autonomous-golf-cart/autonomous-golf-cart/hardware/README.md

# Cart hardware

The cart's custom mounts, enclosures, pedal mechanisms, and steering hardware, with **33 original STL exports** and a shaded CAD render of every component.

Installed cart hardware and steering-wheel assembly

Installed hardware (left) and steering-wheel assembly (right). The annotated photo shows the six-camera configuration, with three cameras facing forward and three facing rearward.

Full landscape component catalog

[Pedal actuation](#pedal-actuation) · [Steering](#steering-and-belt-drive) · [Cameras](#camera-rig) · [Sensors](#sensor-housings) · [Display and connectivity](#display-and-connectivity)

## How the parts fit on the cart

- **Steering:** the chestplate fits over the steering wheel to turn it. The steering models also include the column mount, motor/controller reference, motor pulley, and idler tensioner.
- **Pedals:** linear actuators press the gas and brake from a wooden support structure. The gripper attaches to the column stand and clamps around the steering column, preventing that structure from lifting when the actuators push down on the pedals.
- **Cameras:** camera-specific holders and PVC brackets support the camera rig. The front and back connectors hold the front and rear cameras with vibration dampers.
- **Sensors and accessories:** separate housings support the GPS and IMU; other mounts carry the operator monitor and Starlink equipment.

The installation descriptions above incorporate the builder's identification of the chestplate, gripper, column stand, and front/rear camera connectors. Other component roles follow the export names and the existing subsystem documentation.

## Files and previews

The original filenames and file contents are preserved. Each preview links to its STL; the [landscape component catalog](renders/catalog.png) shows all 33 exports at once and is embedded in both READMEs. The catalog uses Geist Regular for headings, component names, and notes, with Geist Mono Regular for labels, component numbers, and dimensions. It has a white background, warm charcoal text, muted olive details, thin neutral borders, and subtly rounded outer corners. The old front camera holder is retained as a separate revision.

These are **STL mesh exports**, rather than editable Fusion/STEP projects. STL does not encode units: the dimensions below are axis-aligned bounding boxes in the original export axes, **assuming millimeters**. Renders are individually fitted to the frame and are not shown at a common scale. Some exports contain several separate pieces, such as an enclosure and its lid.

## Pedal actuation

The brake and gas cases/covers belong to the pedal actuator assemblies. The piston arm is also shown in the supplied brake-assembly reference. The gripper and column stand retain the wooden pedal-actuator structure.

| CAD preview | Component / original file | Cart location and purpose |
|:--|:--|:--|
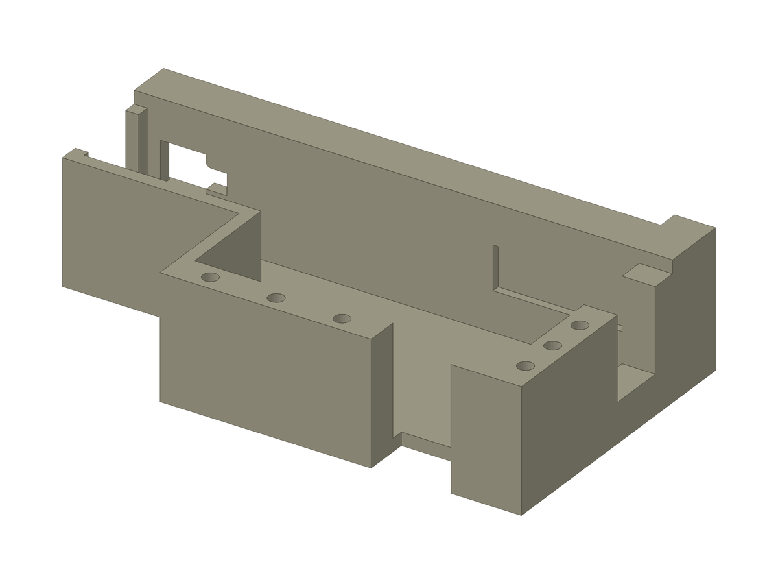
[picture p3: hardware/renders/pedal-case-brake-u.png]
Brake pedal actuator case, shaded CAD view
| [](mechanical/pedals/Pedal%20Case%20%28BRAKE%29%20U.stl) | **Brake pedal actuator case**<br>[Pedal Case (BRAKE) U.stl](mechanical/pedals/Pedal%20Case%20%28BRAKE%29%20U.stl)<br>202.5 × 112.5 × 51.5 mm | Brake pedal assembly: case for the actuator mechanism. |
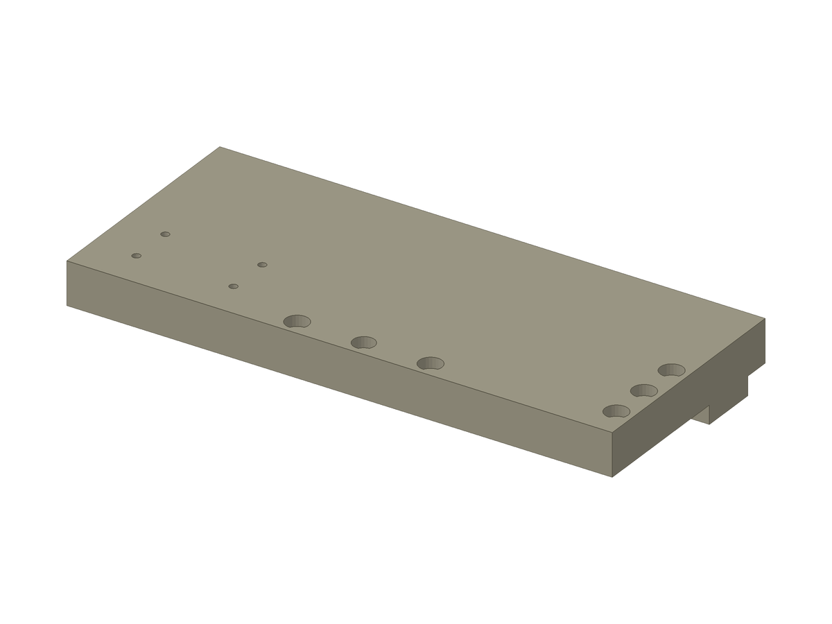
[picture p4: hardware/renders/pedal-cover-brake-u.png]
Brake pedal actuator cover, shaded CAD view
| [](mechanical/pedals/Pedal%20Cover%20%28BRAKE%29%20U.stl) | **Brake pedal actuator cover**<br>[Pedal Cover (BRAKE) U.stl](mechanical/pedals/Pedal%20Cover%20%28BRAKE%29%20U.stl)<br>202.5 × 87.5 × 23 mm | Brake pedal assembly: cover matching the brake case. |
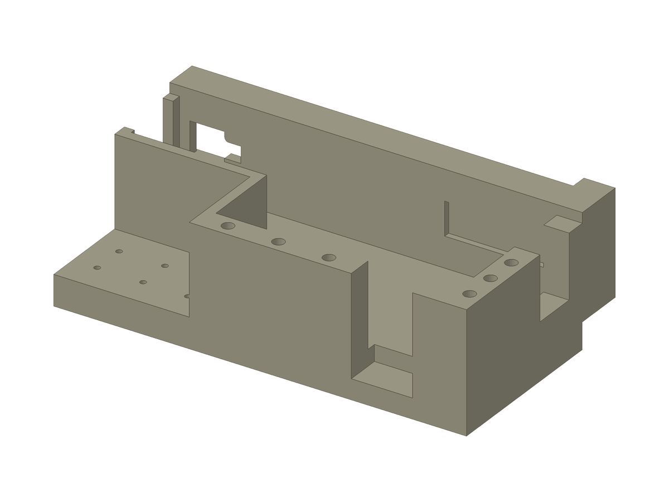
[picture p5: hardware/renders/pedal-case-gas-u.png]
Gas pedal actuator case, shaded CAD view
| [](mechanical/pedals/Pedal%20Case%20%28GAS%29%20U.stl) | **Gas pedal actuator case**<br>[Pedal Case (GAS) U.stl](mechanical/pedals/Pedal%20Case%20%28GAS%29%20U.stl)<br>202.5 × 112.5 × 64.5 mm | Accelerator pedal assembly: case for the actuator mechanism. |
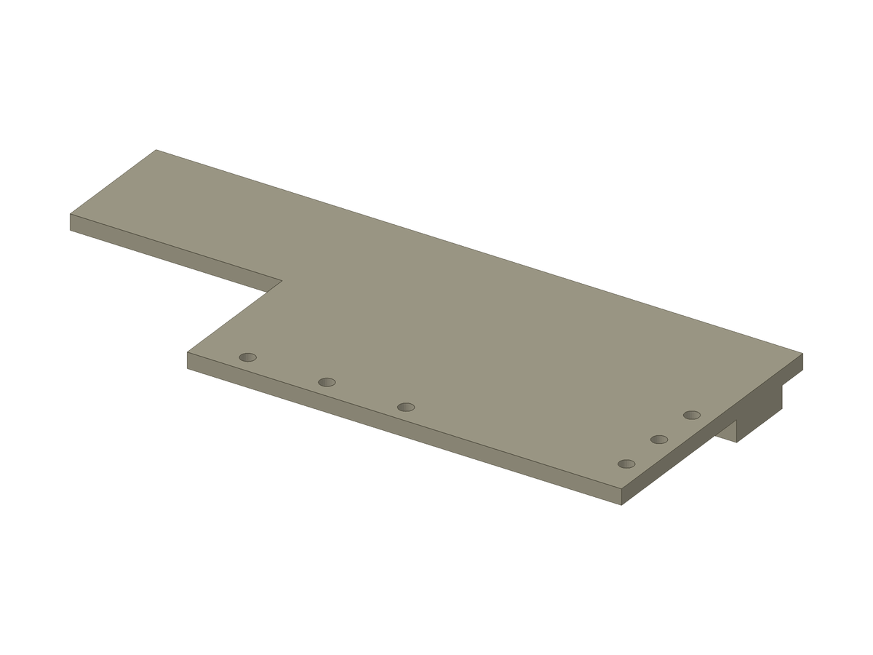
[picture p6: hardware/renders/pedal-cover-gas-u.png]
Gas pedal actuator cover, shaded CAD view
| [](mechanical/pedals/Pedal%20Cover%20%28GAS%29%20U.stl) | **Gas pedal actuator cover**<br>[Pedal Cover (GAS) U.stl](mechanical/pedals/Pedal%20Cover%20%28GAS%29%20U.stl)<br>202.5 × 87.5 × 12 mm | Accelerator pedal assembly: cover matching the gas case. |
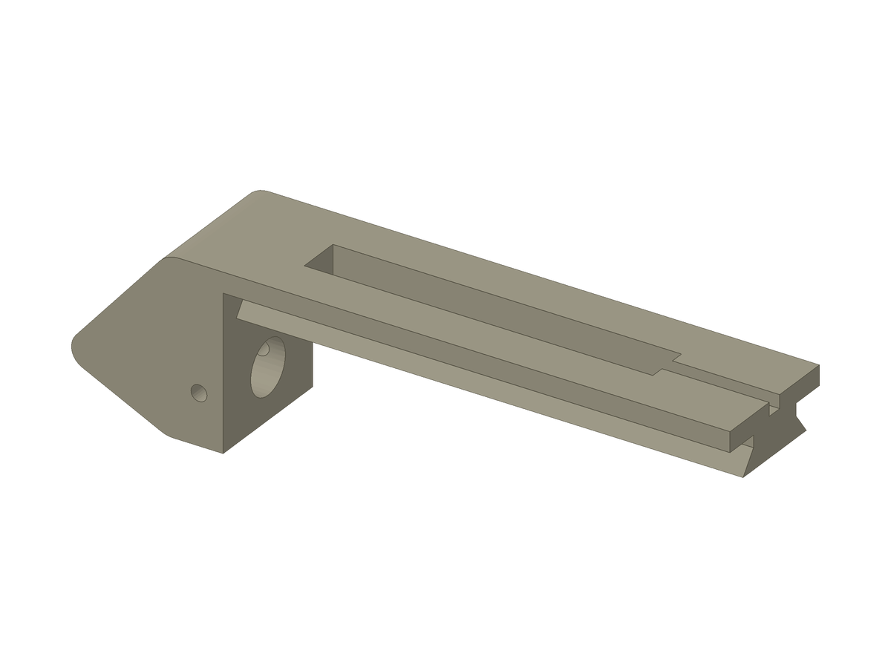
[picture p7: hardware/renders/piston-arm.png]
Piston arm, shaded CAD view
| [](mechanical/pedals/Piston%20Arm.stl) | **Piston arm**<br>[Piston Arm.stl](mechanical/pedals/Piston%20Arm.stl)<br>245.6 × 51.5 × 65 mm | Pedal actuation linkage; also visible as a component in the supplied brake-assembly reference. |
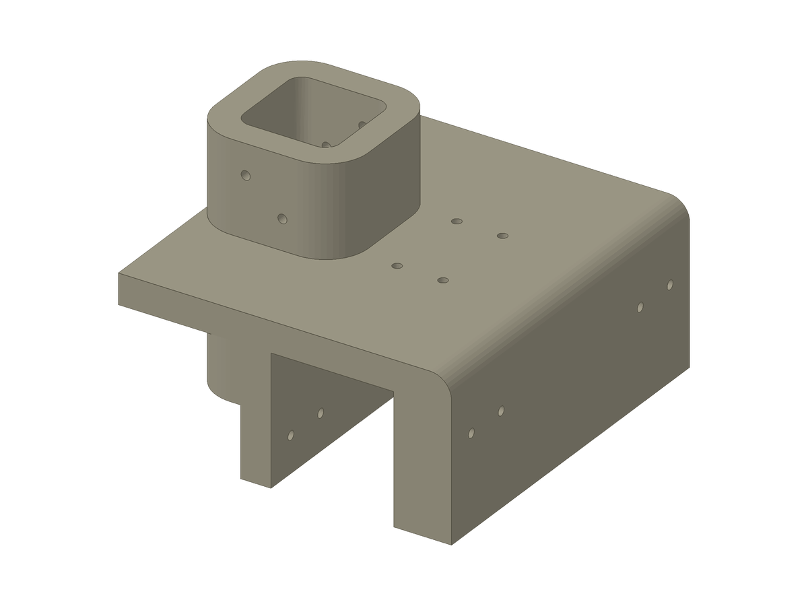
[picture p8: hardware/renders/column-stand.png]
Column stand, shaded CAD view
| [](mechanical/pedals/Column%20Stand.stl) | **Column stand**<br>[Column Stand.stl](mechanical/pedals/Column%20Stand.stl)<br>109 × 120 × 82.5 mm | Pedal-frame retention: the stand to which the gripper attaches, linking the wooden actuator-support structure to the clamp on the steering column. |
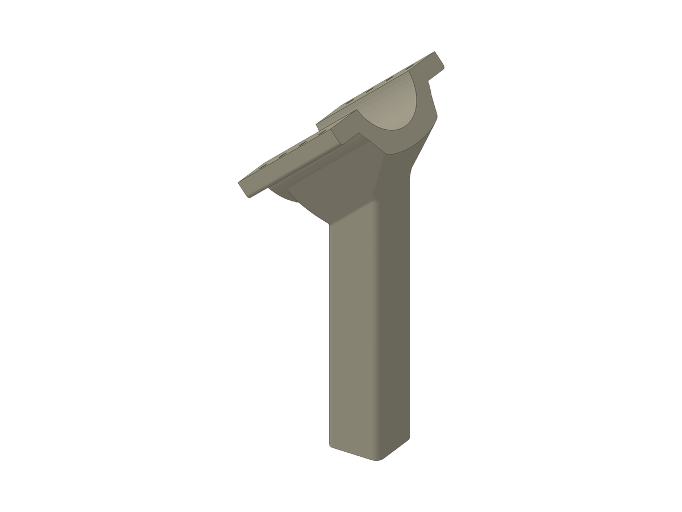
[picture p9: hardware/renders/gripper.png]
Gripper, shaded CAD view
| [](mechanical/pedals/Gripper.stl) | **Gripper**<br>[Gripper.stl](mechanical/pedals/Gripper.stl)<br>72.4 × 91.3 × 193.6 mm | Pedal-frame retention: connected to the column stand and clamped around the steering column to keep the wooden actuator frame from lifting as the actuators press the gas or brake. |
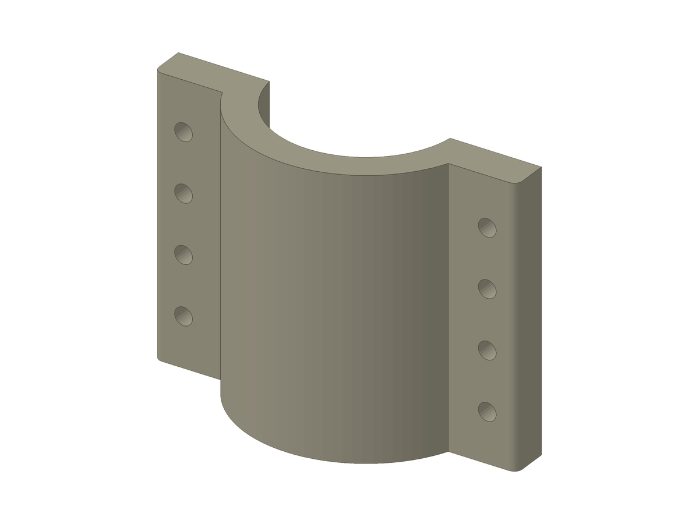
[picture p10: hardware/renders/gripper-cover.png]
Gripper cover, shaded CAD view
| [](mechanical/pedals/Gripper%20Cover.stl) | **Gripper cover**<br>[Gripper Cover.stl](mechanical/pedals/Gripper%20Cover.stl)<br>91.3 × 28.3 × 69.5 mm | Pedal-frame retention: mating cover for the gripper clamp around the steering column, securing the wooden pedal-actuator frame against lift. |

## Steering and belt drive

The chestplate is the steering-wheel interface. These parts support the ODrive-driven steering system and belt transmission. The motor export contains reference geometry for the motor and controller.

| CAD preview | Component / original file | Cart location and purpose |
|:--|:--|:--|
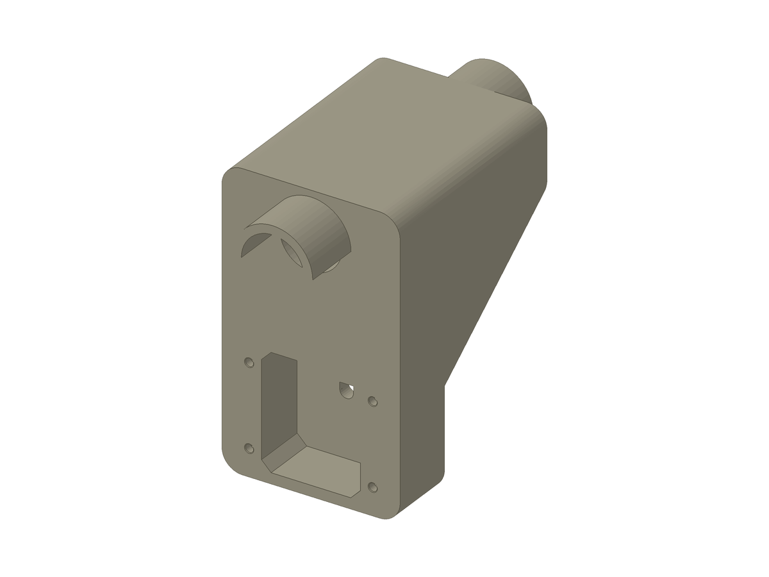
[picture p11: hardware/renders/steering-column-mount.png]
Steering column mount, shaded CAD view
| [](mechanical/steering/Steering%20Column%20Mount.stl) | **Steering column mount**<br>[Steering Column Mount.stl](mechanical/steering/Steering%20Column%20Mount.stl)<br>130 × 248 × 214 mm | Steering assembly: mounting bracket at the steering column. |
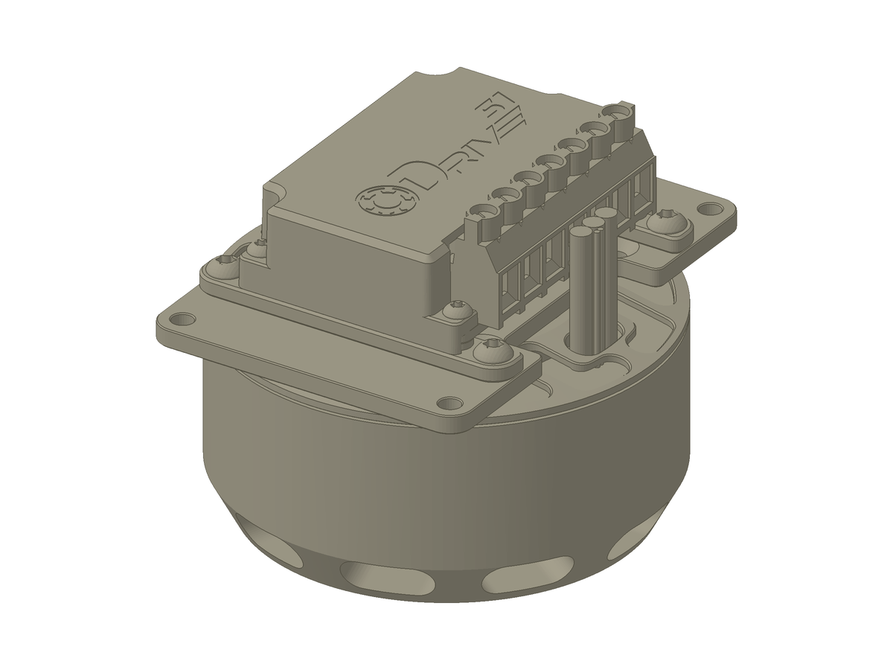
[picture p12: hardware/renders/motor.png]
Steering motor and controller model, shaded CAD view
| [](mechanical/steering/Motor.stl) | **Steering motor and controller model**<br>[Motor.stl](mechanical/steering/Motor.stl)<br>91.7 × 100 × 85.4 mm | Steering assembly: supplied motor and controller geometry for packaging and fit reference; not identified as a printable custom part. |
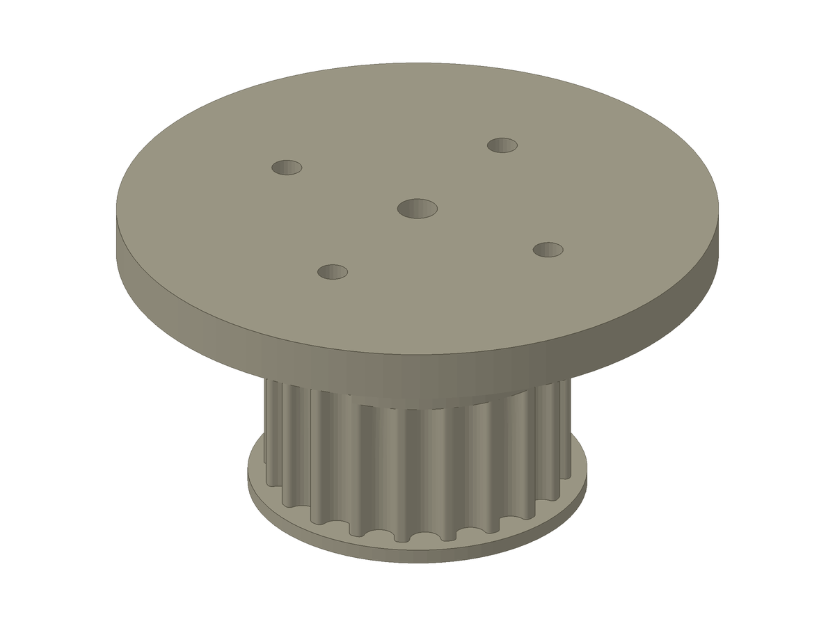
[picture p13: hardware/renders/motor-belt-pulley.png]
Motor belt pulley, shaded CAD view
| [](mechanical/steering/Motor%20Belt%20Pulley.stl) | **Motor belt pulley**<br>[Motor Belt Pulley.stl](mechanical/steering/Motor%20Belt%20Pulley.stl)<br>60 × 60 × 31 mm | Steering belt drive: pulley on the motor side. |
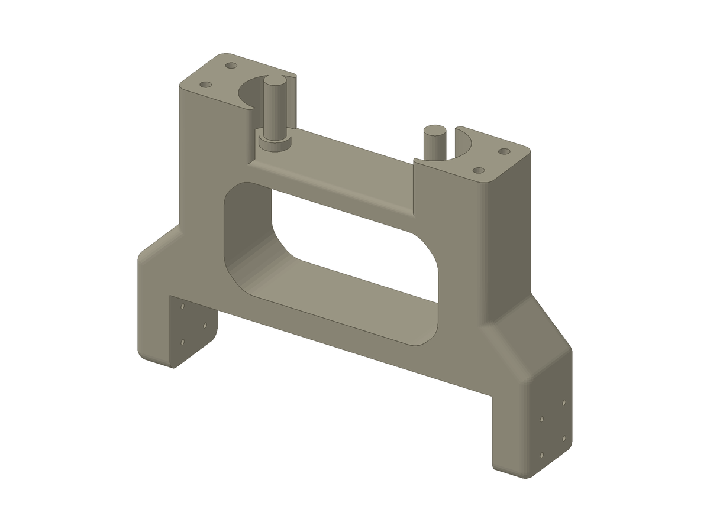
[picture p14: hardware/renders/idler-tensioner-body.png]
Idler tensioner body, shaded CAD view
| [](mechanical/steering/Idler%20Tensioner%20Body.stl) | **Idler tensioner body**<br>[Idler Tensioner Body.stl](mechanical/steering/Idler%20Tensioner%20Body.stl)<br>161 × 30 × 117 mm | Steering belt drive: body of the idler/tensioner assembly. |
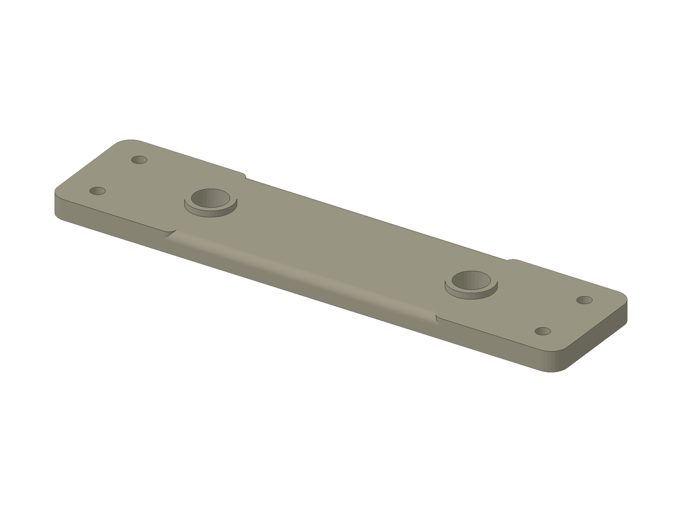
[picture p15: hardware/renders/idler-tensioner-cover.png]
Idler tensioner cover, shaded CAD view
| [](mechanical/steering/Idler%20Tensioner%20Cover.stl) | **Idler tensioner cover**<br>[Idler Tensioner Cover.stl](mechanical/steering/Idler%20Tensioner%20Cover.stl)<br>127 × 30 × 6.5 mm | Steering belt drive: cover for the idler/tensioner assembly. |
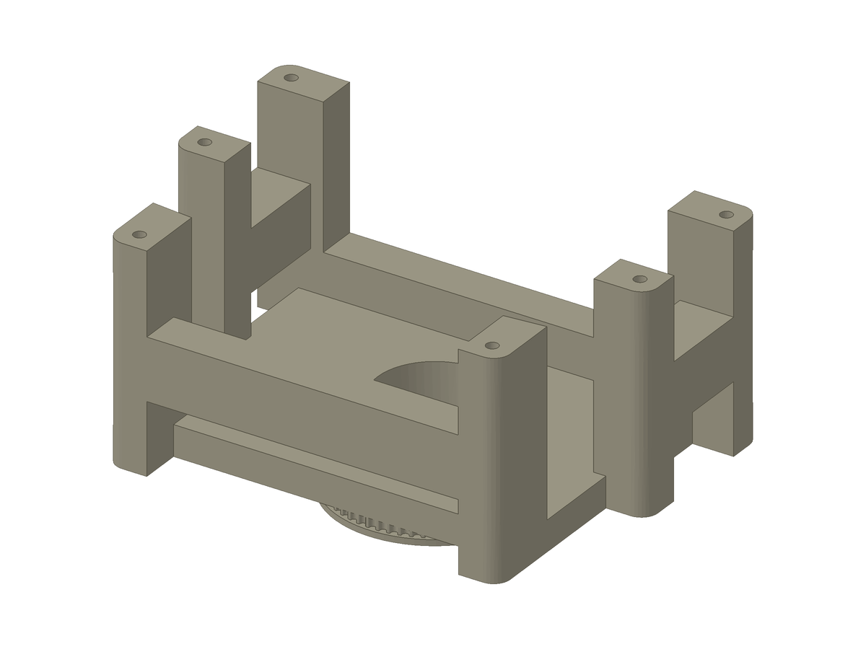
[picture p16: hardware/renders/chestplate-mount.png]
Chestplate mount, shaded CAD view
| [](mechanical/steering/Chestplate%20Mount.stl) | **Chestplate mount**<br>[Chestplate Mount.stl](mechanical/steering/Chestplate%20Mount.stl)<br>231 × 164 × 133.5 mm | Steering-wheel interface: chestplate fitted over the steering wheel to transmit the steering drive and turn the wheel. |
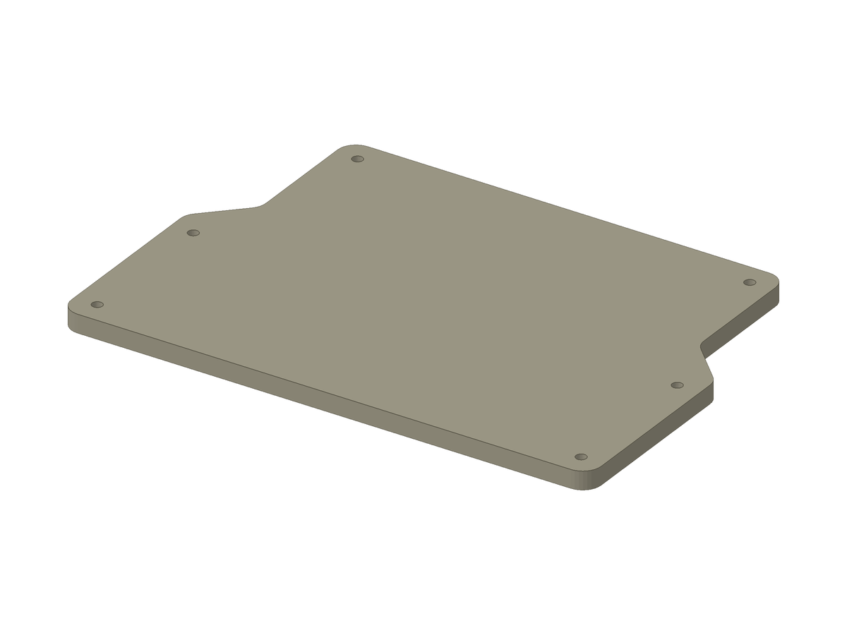
[picture p17: hardware/renders/chestplate-cover.png]
Chestplate cover, shaded CAD view
| [](mechanical/steering/Chestplate%20Cover.stl) | **Chestplate cover**<br>[Chestplate Cover.stl](mechanical/steering/Chestplate%20Cover.stl)<br>231 × 164 × 8 mm | Steering-wheel interface: cover for the chestplate assembly fitted over the steering wheel. |

## Camera rig

Front, rear, side, and PVC-mounted camera hardware, including the vibration-damped front/rear connectors. The filename marked `OLD` is an earlier front-holder revision.

| CAD preview | Component / original file | Cart location and purpose |
|:--|:--|:--|
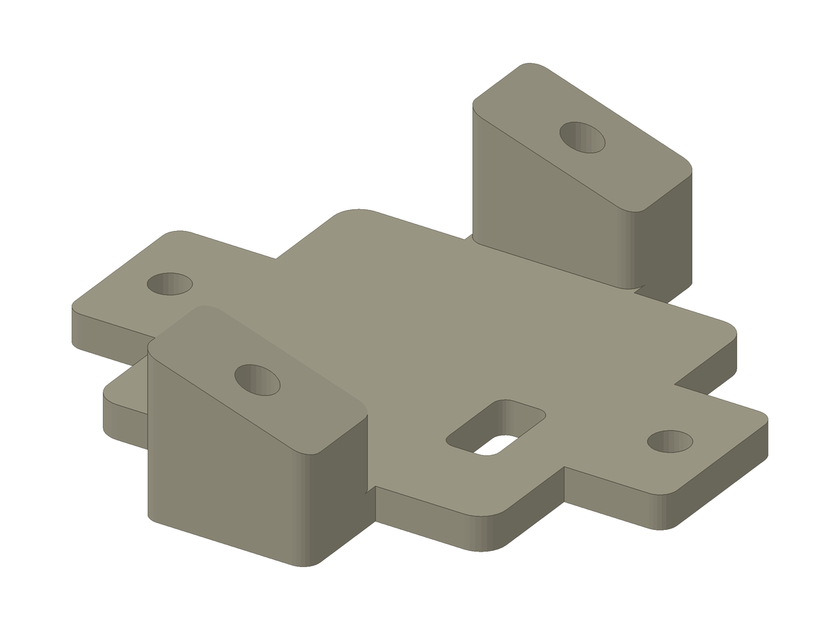
[picture p18: hardware/renders/cam-to-cart-mount.png]
Camera-to-cart mount, shaded CAD view
| [](mechanical/cameras/Cam%20to%20Cart%20Mount.stl) | **Camera-to-cart mount**<br>[Cam to Cart Mount.stl](mechanical/cameras/Cam%20to%20Cart%20Mount.stl)<br>71 × 71 × 19 mm | Camera rig: mounting interface between a camera bracket and the cart. |
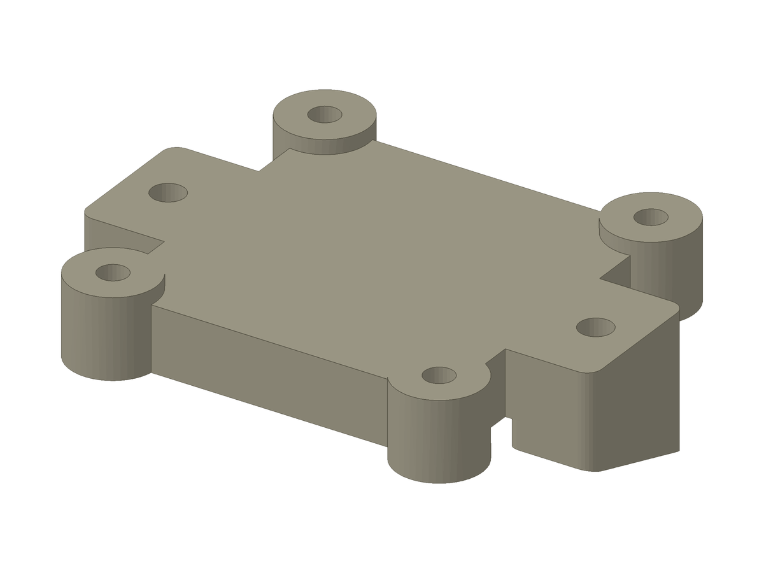
[picture p19: hardware/renders/front-cam-attachment.png]
Front camera attachment, shaded CAD view
| [](mechanical/cameras/Front%20Cam%20Attachment.stl) | **Front camera attachment**<br>[Front Cam Attachment.stl](mechanical/cameras/Front%20Cam%20Attachment.stl)<br>71 × 57 × 21 mm | Front camera rig: attachment plate/interface. |
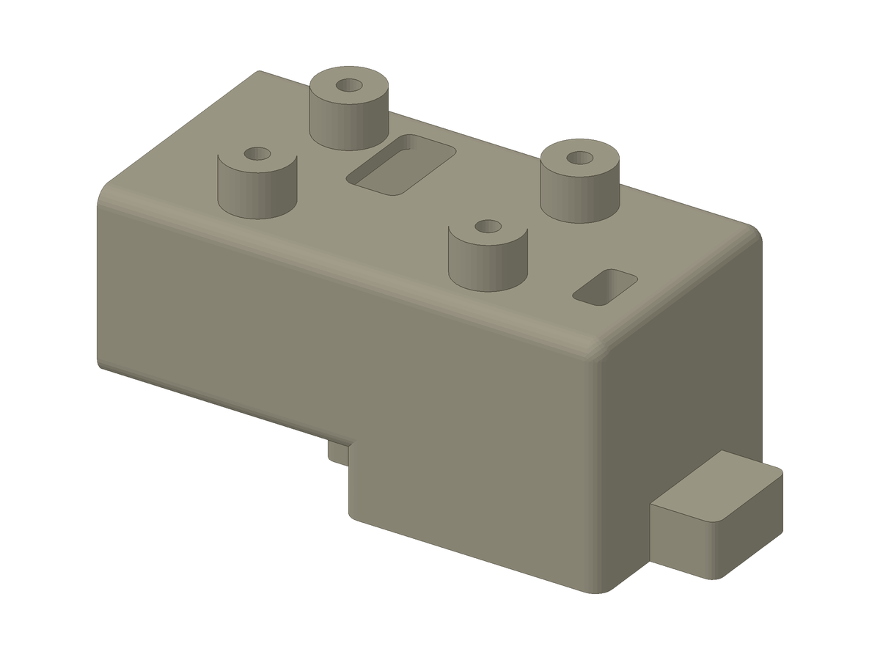
[picture p20: hardware/renders/front-cam-holder.png]
Front camera holder, shaded CAD view
| [](mechanical/cameras/Front%20Cam%20Holder.stl) | **Front camera holder**<br>[Front Cam Holder.stl](mechanical/cameras/Front%20Cam%20Holder.stl)<br>103 × 47 × 51 mm | Front camera rig: camera holder. |
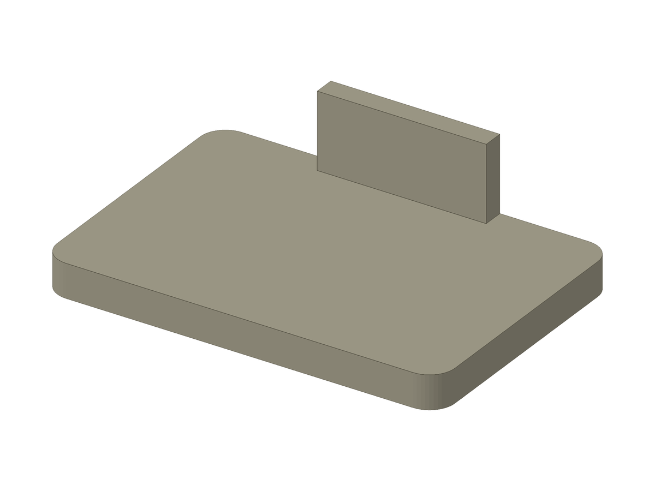
[picture p21: hardware/renders/front-cam-cap.png]
Front camera cap, shaded CAD view
| [](mechanical/cameras/Front%20Cam%20Cap.stl) | **Front camera cap**<br>[Front Cam Cap.stl](mechanical/cameras/Front%20Cam%20Cap.stl)<br>47 × 32 × 13 mm | Front camera rig: cap for the front camera holder. |
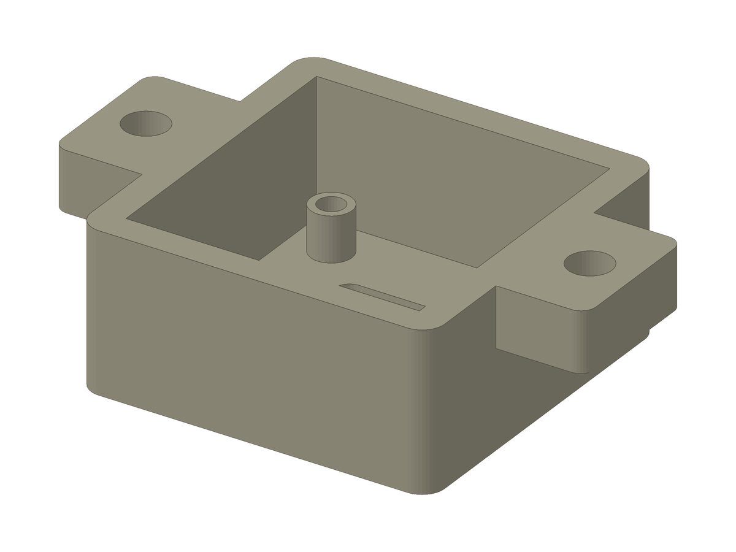
[picture p22: hardware/renders/front-wide-cam-holder.png]
Front wide-camera holder, shaded CAD view
| [](mechanical/cameras/Front%20Wide%20Cam%20Holder.stl) | **Front wide-camera holder**<br>[Front Wide Cam Holder.stl](mechanical/cameras/Front%20Wide%20Cam%20Holder.stl)<br>71 × 47 × 22 mm | Front wide-angle camera: camera holder. |
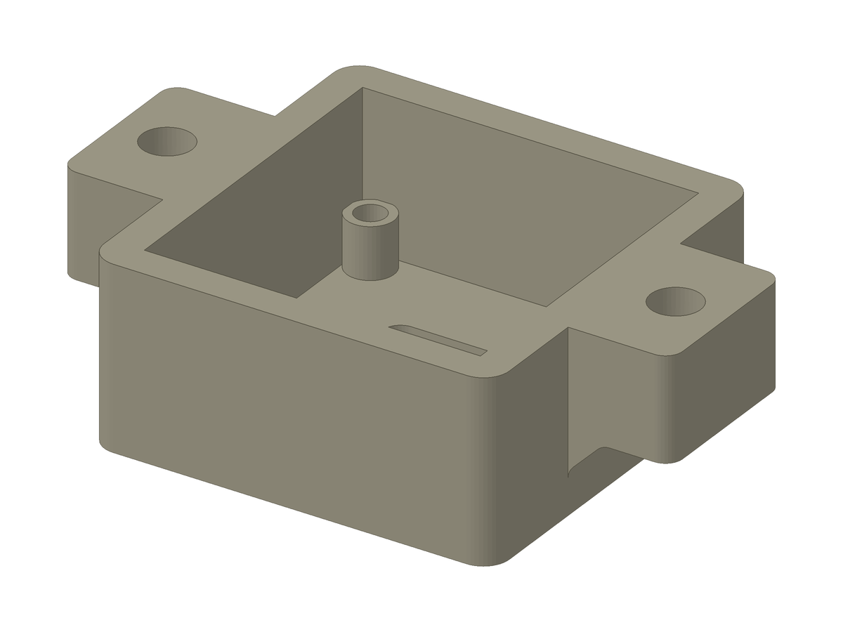
[picture p23: hardware/renders/side-cam-holder.png]
Side camera holder, shaded CAD view
| [](mechanical/cameras/Side%20Cam%20Holder.stl) | **Side camera holder**<br>[Side Cam Holder.stl](mechanical/cameras/Side%20Cam%20Holder.stl)<br>71 × 47 × 22 mm | Side-facing camera rig: camera holder. |
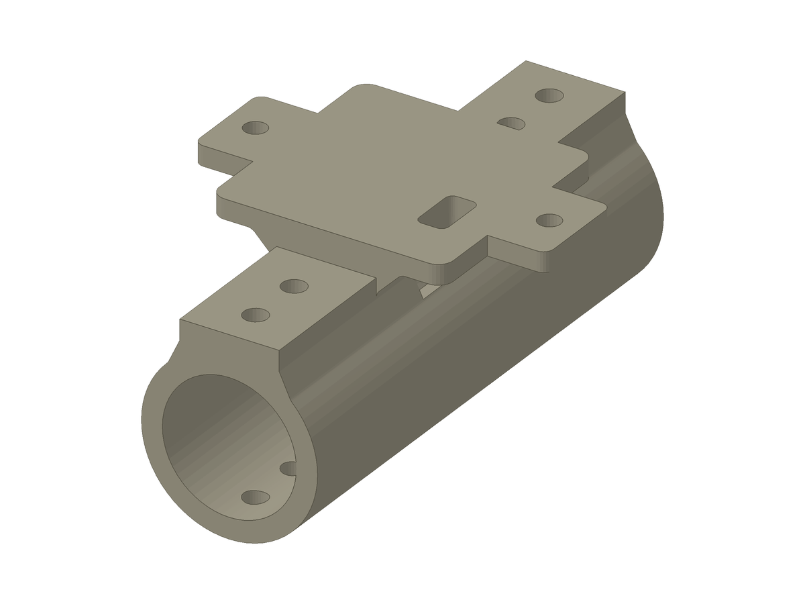
[picture p24: hardware/renders/pvc-cam-holder-norm.png]
PVC camera holder, normal, shaded CAD view
| [](mechanical/cameras/PVC%20Cam%20Holder%20Norm.stl) | **PVC camera holder, normal**<br>[PVC Cam Holder Norm.stl](mechanical/cameras/PVC%20Cam%20Holder%20Norm.stl)<br>71 × 107 × 45.4 mm | PVC camera rig: normal variant of the tube-mounted bracket. |
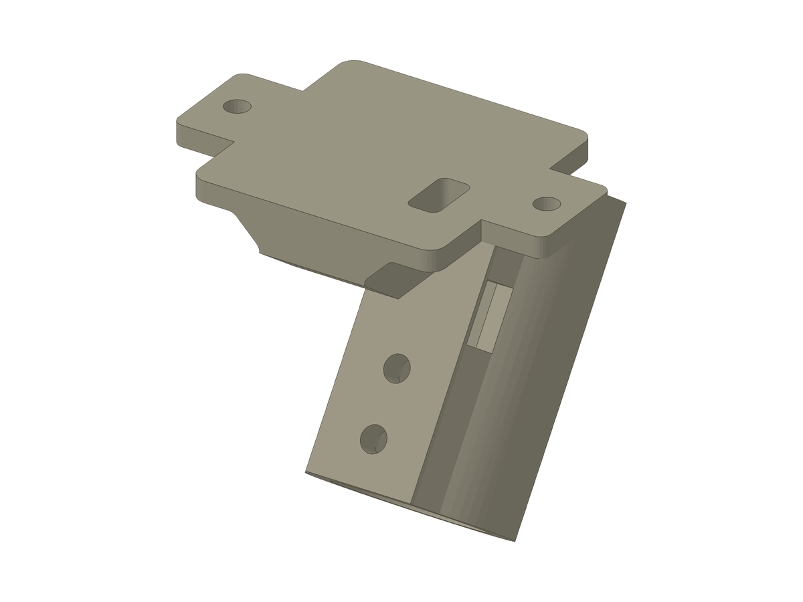
[picture p25: hardware/renders/pvc-cam-holder-left.png]
PVC camera holder, left, shaded CAD view
| [](mechanical/cameras/PVC%20Cam%20Holder%20Left.stl) | **PVC camera holder, left**<br>[PVC Cam Holder Left.stl](mechanical/cameras/PVC%20Cam%20Holder%20Left.stl)<br>71 × 76 × 77 mm | PVC camera rig: left variant of the tube-mounted bracket. |
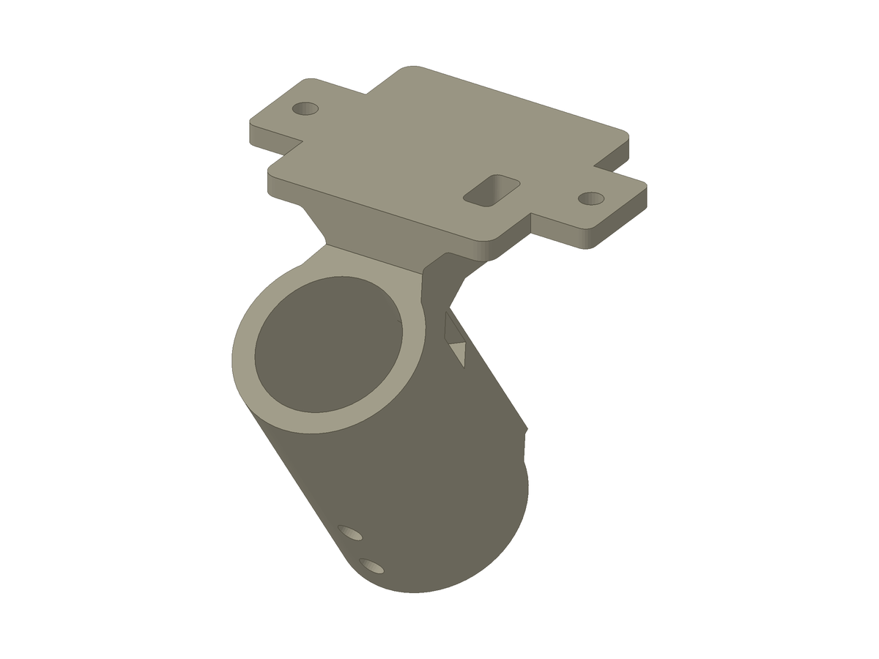
[picture p26: hardware/renders/pvc-cam-holder-right.png]
PVC camera holder, right, shaded CAD view
| [](mechanical/cameras/PVC%20Cam%20Holder%20Right.stl) | **PVC camera holder, right**<br>[PVC Cam Holder Right.stl](mechanical/cameras/PVC%20Cam%20Holder%20Right.stl)<br>71 × 76 × 77 mm | PVC camera rig: right variant of the tube-mounted bracket. |
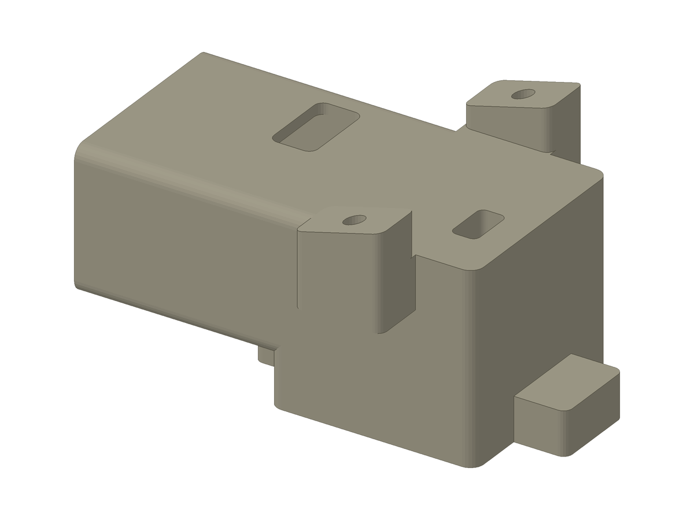
[picture p27: hardware/renders/front-cam-holder-old.png]
Front camera holder, old revision, shaded CAD view
| [](mechanical/cameras/Front%20Cam%20Holder%20%28OLD%29.stl) | **Front camera holder, old revision**<br>[Front Cam Holder (OLD).stl](mechanical/cameras/Front%20Cam%20Holder%20%28OLD%29.stl)<br>103 × 71 × 53 mm | Earlier front camera holder export; retained separately from the unmarked revision. |
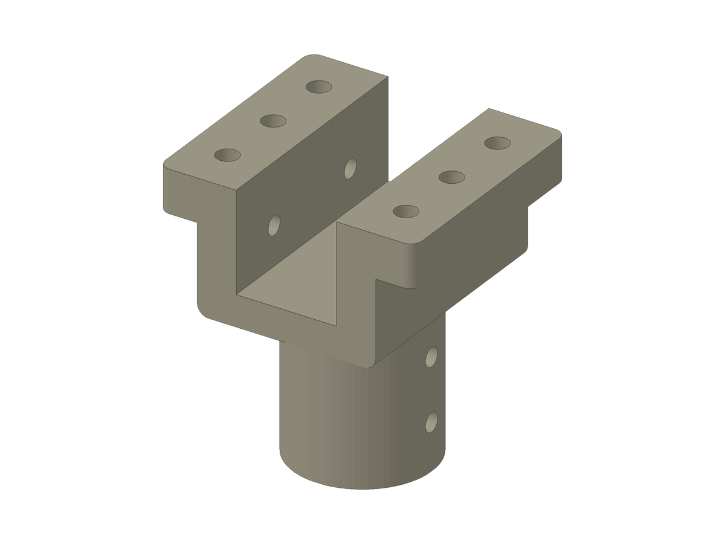
[picture p28: hardware/renders/front-connector.png]
Front connector, shaded CAD view
| [](mechanical/cameras/Front%20Connector.stl) | **Front connector**<br>[Front Connector.stl](mechanical/cameras/Front%20Connector.stl)<br>65.7 × 60 × 73.6 mm | Front camera mounting: holds the front camera in place with a vibration damper. |
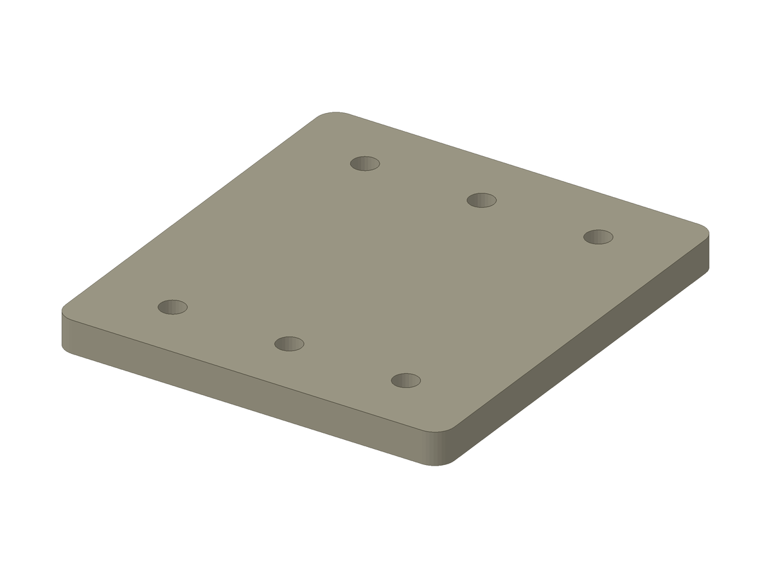
[picture p29: hardware/renders/front-connector-cap.png]
Front connector cap, shaded CAD view
| [](mechanical/cameras/Front%20Connector%20Cap.stl) | **Front connector cap**<br>[Front Connector Cap.stl](mechanical/cameras/Front%20Connector%20Cap.stl)<br>60 × 65.7 × 5 mm | Front camera mounting: cap for the vibration-damped front connector assembly. |
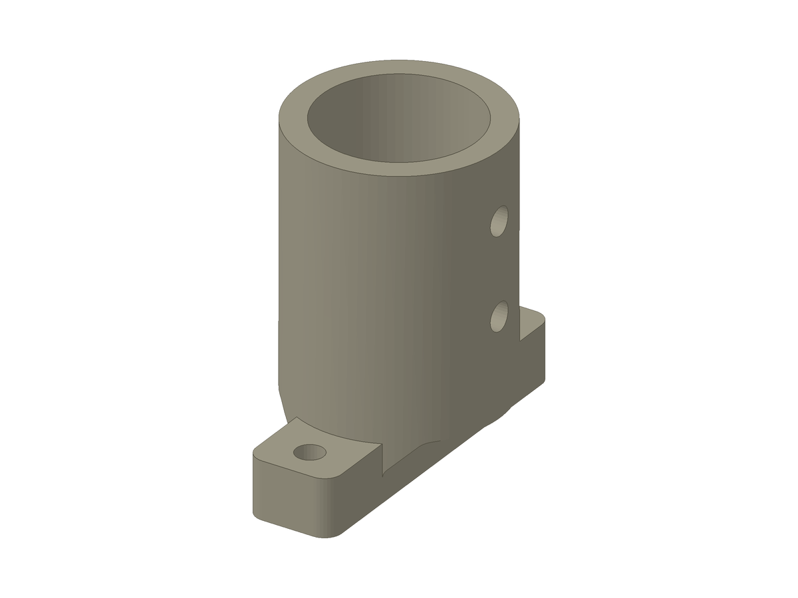
[picture p30: hardware/renders/back-connector.png]
Back connector, shaded CAD view
| [](mechanical/cameras/Back%20Connector.stl) | **Back connector**<br>[Back Connector.stl](mechanical/cameras/Back%20Connector.stl)<br>35.4 × 60 × 55 mm | Rear camera mounting: holds the rear camera in place with a vibration damper. |

## Sensor housings

Dedicated housings for the GPS and IMU. Each export includes its separately positioned lid.

| CAD preview | Component / original file | Cart location and purpose |
|:--|:--|:--|
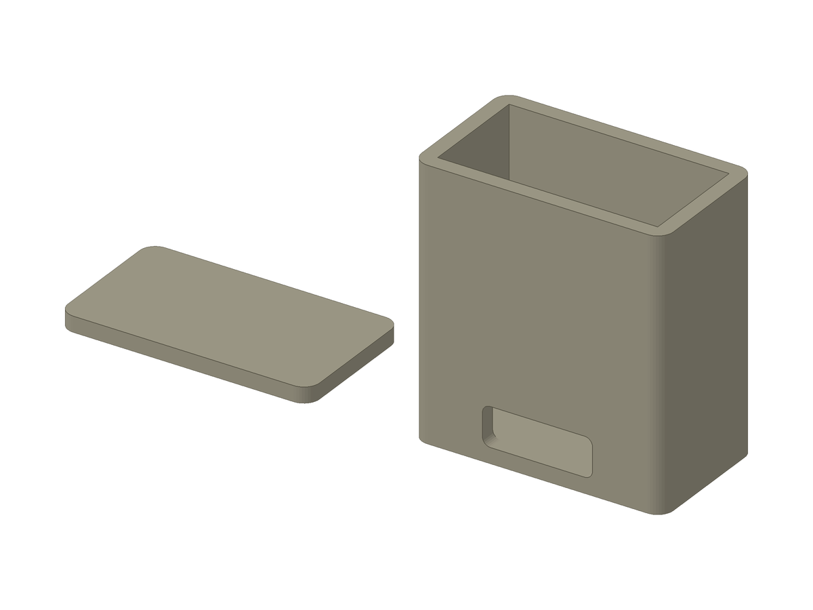
[picture p31: hardware/renders/gps-housing.png]
GPS housing, shaded CAD view
| [](mechanical/sensors/GPS%20Housing.stl) | **GPS housing**<br>[GPS Housing.stl](mechanical/sensors/GPS%20Housing.stl)<br>77 × 18 × 34 mm | GPS sensor mounting: housing export includes the enclosure and a separate lid. |
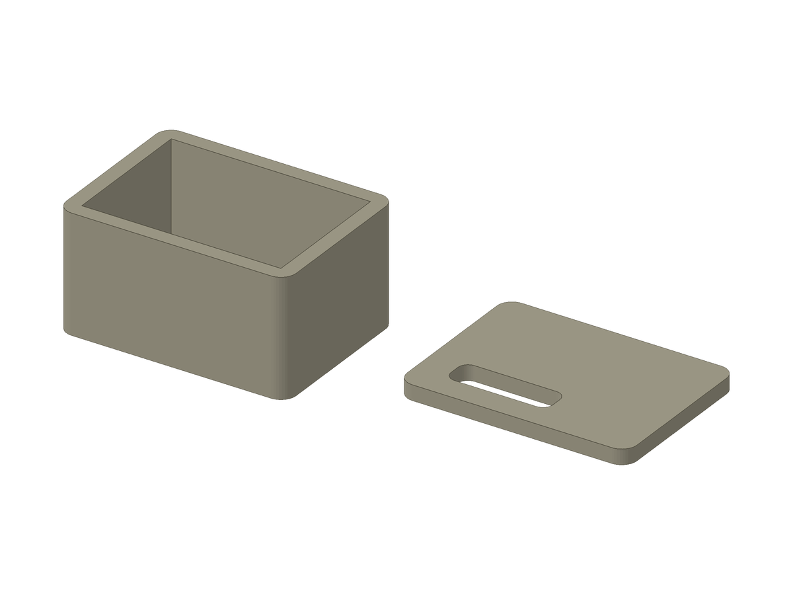
[picture p32: hardware/renders/imu-holster.png]
IMU holster, shaded CAD view
| [](mechanical/sensors/IMU%20Holster.stl) | **IMU holster**<br>[IMU Holster.stl](mechanical/sensors/IMU%20Holster.stl)<br>103.9 × 45 × 23 mm | IMU sensor mounting: holster export includes the enclosure and a separate lid. |

## Display and connectivity

Mounts for the operator display and Starlink equipment.

| CAD preview | Component / original file | Cart location and purpose |
|:--|:--|:--|
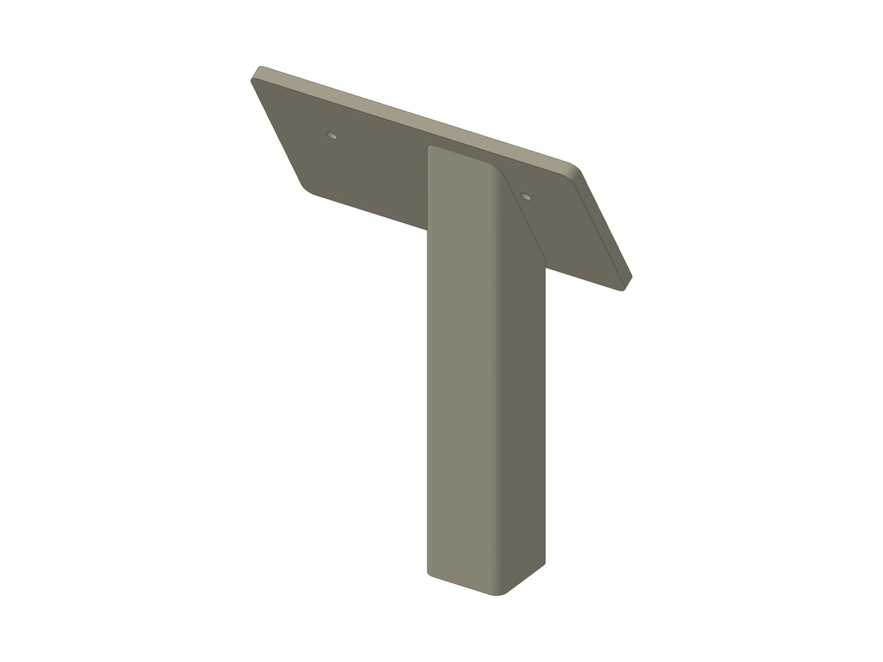
[picture p33: hardware/renders/monitor-mount.png]
Monitor mount, shaded CAD view
| [](mechanical/accessories/Monitor%20Mount.stl) | **Monitor mount**<br>[Monitor Mount.stl](mechanical/accessories/Monitor%20Mount.stl)<br>125 × 38.3 × 169.4 mm | Operator display: mounting bracket for the monitor. |
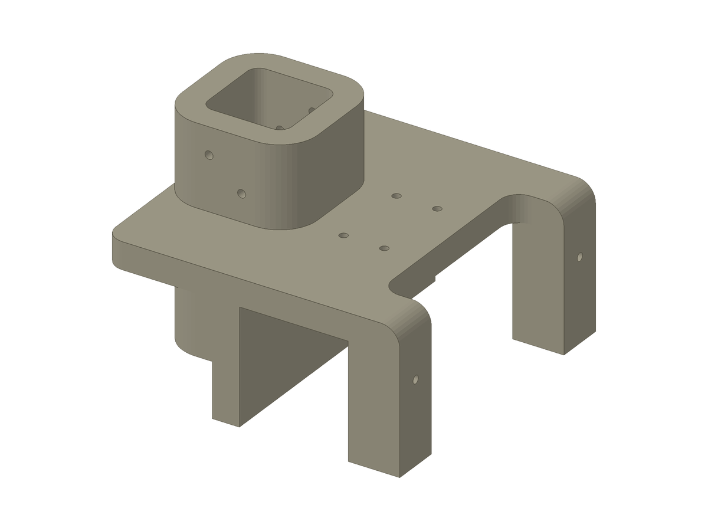
[picture p34: hardware/renders/monitor-stand.png]
Monitor stand, shaded CAD view
| [](mechanical/accessories/Monitor%20Stand.stl) | **Monitor stand**<br>[Monitor Stand.stl](mechanical/accessories/Monitor%20Stand.stl)<br>109 × 111 × 82.5 mm | Operator display: support stand for the monitor. |
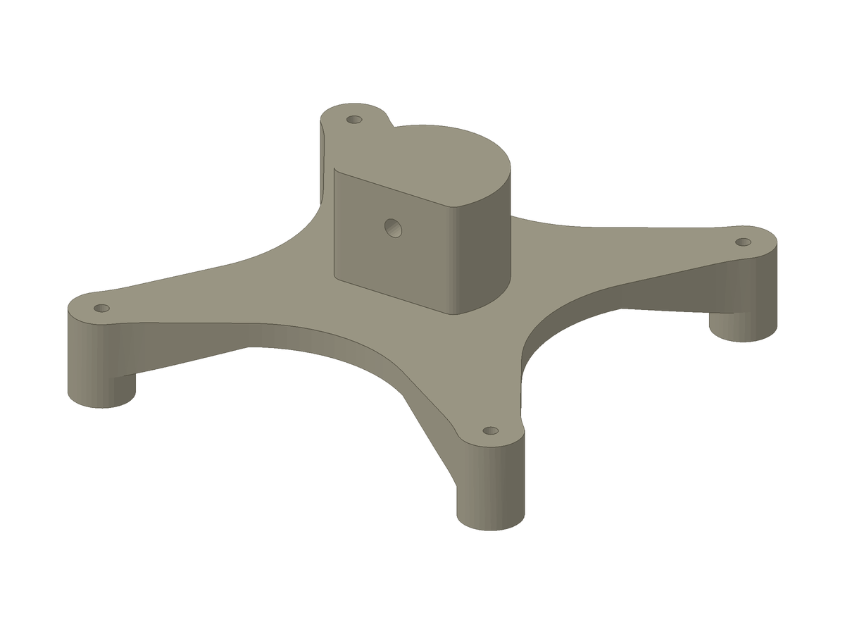
[picture p35: hardware/renders/starlink-mount.png]
Starlink mount, shaded CAD view
| [](mechanical/accessories/Starlink%20Mount.stl) | **Starlink mount**<br>[Starlink Mount.stl](mechanical/accessories/Starlink%20Mount.stl)<br>155.9 × 155.8 × 64 mm | Connectivity hardware: mount for the Starlink equipment. |

## Hardware and firmware

| Subsystem | Hardware documented in this repository |
|:--|:--|
| Compute | NVIDIA Jetson AGX Thor |
| Steering | ODrive S1 + M8325s motor, 3:1 HTD 5M belt drive |
| Pedals | 2 linear actuators with potentiometer feedback, 2 BTS7960 H-bridges, Arduino Mega 2560 |
| GNSS | u-blox ZED-F9x RTK receiver with NTRIP corrections |
| Cameras | USB camera rig; the annotated photo shows six cameras, three front and three rear |
| Safety | Hardware e-stop and firmware heartbeat watchdog |
| Power | 48 V cart pack with dedicated 12 V and 5 V buck rails |

Subsystem documentation: [steering](../docs/steering.md) · [pedal actuators](../docs/linear_actuators.md) · [e-stop](../docs/estop.md) · [GPS](../docs/gps.md) · [cameras](../docs/cameras.md).

## Directory guide

| Directory | Contents |
|:--|:--|
| [`mechanical/pedals/`](mechanical/pedals/) | Gas/brake cases and covers, piston arm, gripper, and column stand. |
| [`mechanical/steering/`](mechanical/steering/) | Chestplate, steering column mount, motor reference, pulley, and tensioner. |
| [`mechanical/cameras/`](mechanical/cameras/) | Camera holders, caps, attachment plates, and damped connector brackets. |
| [`mechanical/sensors/`](mechanical/sensors/) | GPS housing and IMU holster. |
| [`mechanical/accessories/`](mechanical/accessories/) | Monitor and Starlink mounts. |
| [`cad/catalog.json`](cad/catalog.json) | Component descriptions, paths, mesh dimensions, triangle counts, and original-file SHA-256 checksums. |
| [`renders/`](renders/) | One PNG per export, selected-parts overview, and full catalog. |
| [`photos/`](photos/) | Annotated photo of the installed cart hardware and steering assembly. |
| [`tools/`](tools/) | Reproducible geometry renderer. |
| [`arduino-sketches/`](arduino-sketches/) | Pedal control, watchdog, sensor-validation firmware, and upload tooling. See its [README](arduino-sketches/README.md). |
| [`sensors/calibration/`](sensors/calibration/) | Camera intrinsics/extrinsics and calibration boards. |

## Regenerate the renders

The renderer reads the actual STL triangles, shades them in an orthographic view, and adds visible silhouettes and creases against a white background. It uses a depth buffer so hidden faces do not show through the models.

From the repository root, with Python, NumPy, and Pillow installed:

```bash
python3 hardware/tools/render_cad.py
```

Render one component or rebuild the overview/catalog from existing PNGs:

```bash
python3 hardware/tools/render_cad.py --only pedal-case-brake-u
python3 hardware/tools/render_cad.py --sheets-only
```

The component IDs and metadata live in [`cad/catalog.json`](cad/catalog.json). [Geist and Geist Mono](tools/fonts/geist/) font files and their license are bundled, so the images regenerate with the same typography on any machine. The render script does not modify the source STLs.
