autonomous-golf-cart/autonomous-golf-cart/hardware/renders/overview.png

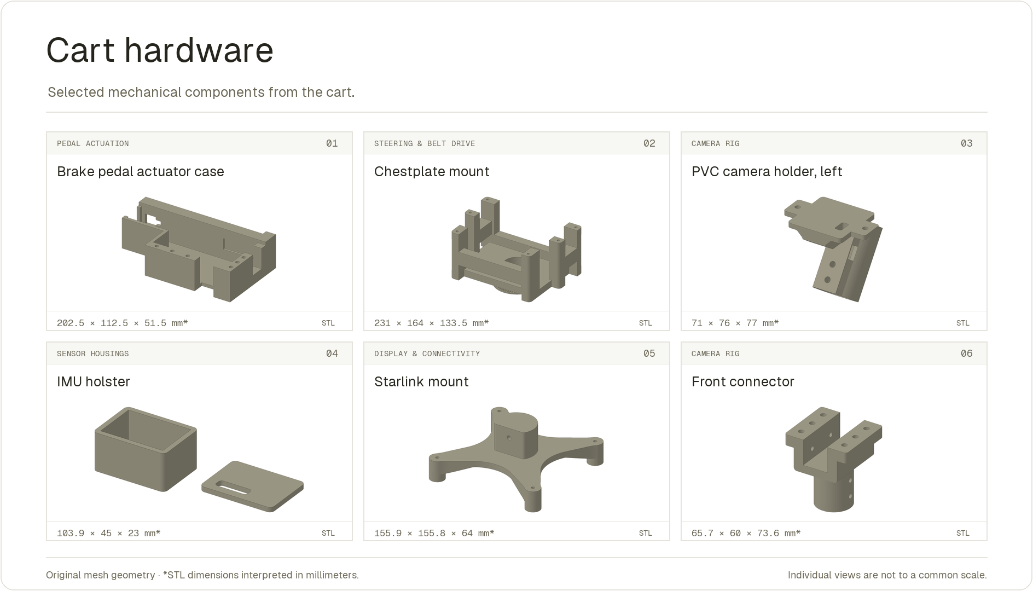
hardware/renders/overview.png
