autonomous-golf-cart/autonomous-golf-cart/hardware/mechanical/accessories/Monitor Stand.stl

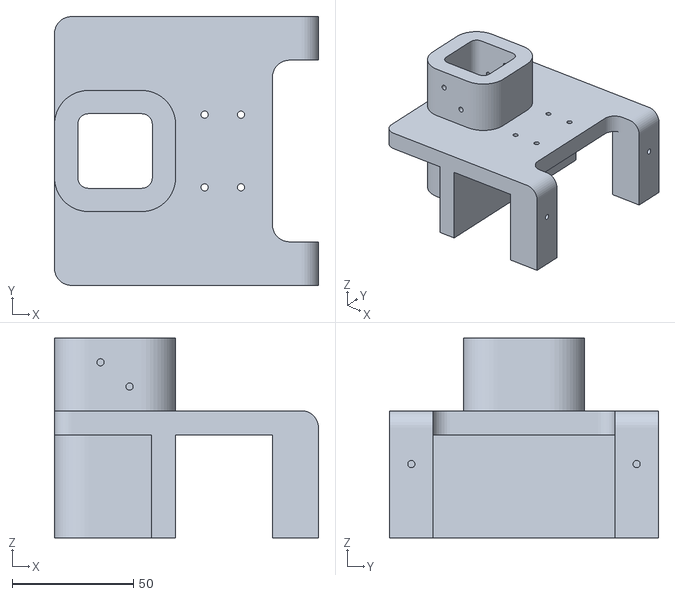
[picture p37: CAD file, 2026-10-18]
hardware/mechanical/accessories/Monitor Stand.stl
109.0 x 111.0 x 82.5
