autonomous-golf-cart/autonomous-golf-cart/hardware/mechanical/cameras/Cam to Cart Mount.stl

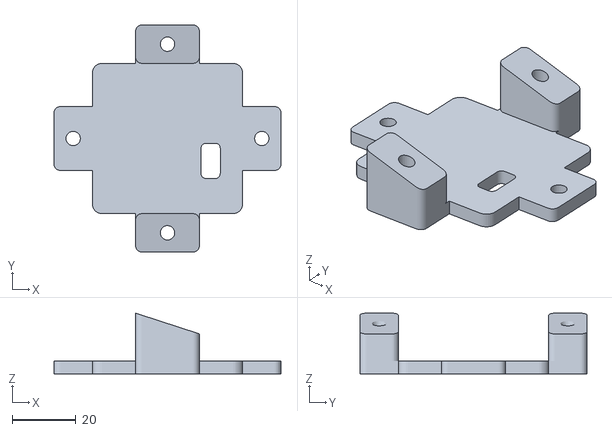
[picture p38: CAD file, 2026-10-18]
hardware/mechanical/cameras/Cam to Cart Mount.stl
71.0 x 71.0 x 19.0
