autonomous-golf-cart/autonomous-golf-cart/hardware/mechanical/pedals/Pedal Case (BRAKE) U.stl

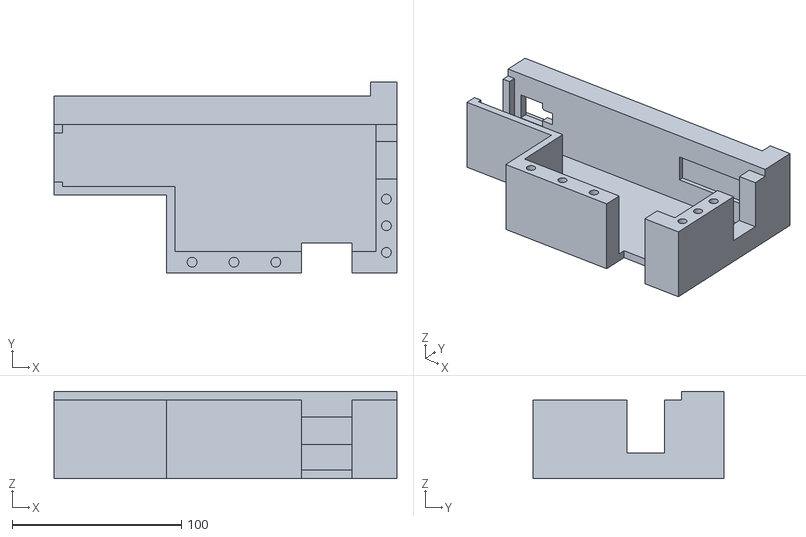
[picture p39: CAD file, 2026-10-18]
hardware/mechanical/pedals/Pedal Case (BRAKE) U.stl
202.5 x 112.5 x 51.5
