autonomous-golf-cart/autonomous-golf-cart/hardware/mechanical/sensors/GPS Housing.stl

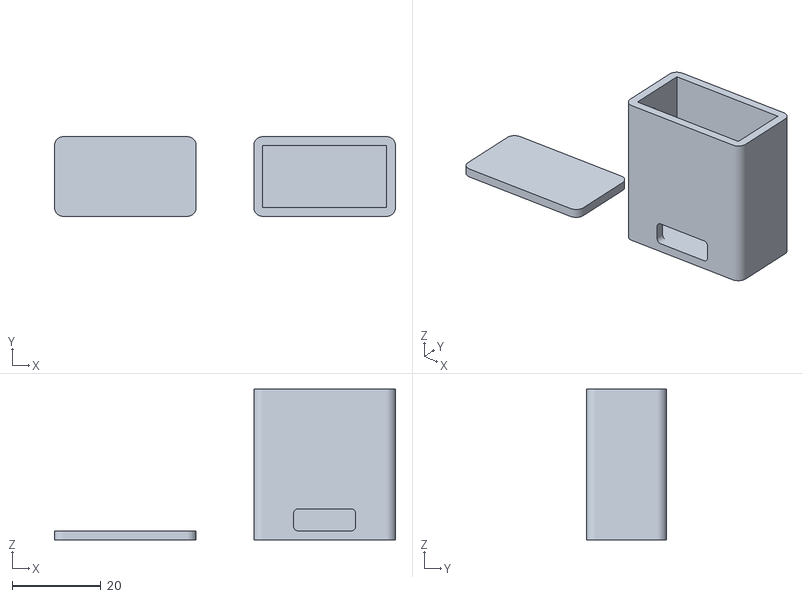
[picture p40: CAD file, 2026-10-18]
hardware/mechanical/sensors/GPS Housing.stl
77.0 x 18.0 x 34.0
