autonomous-golf-cart/autonomous-golf-cart/hardware/mechanical/steering/Motor.stl

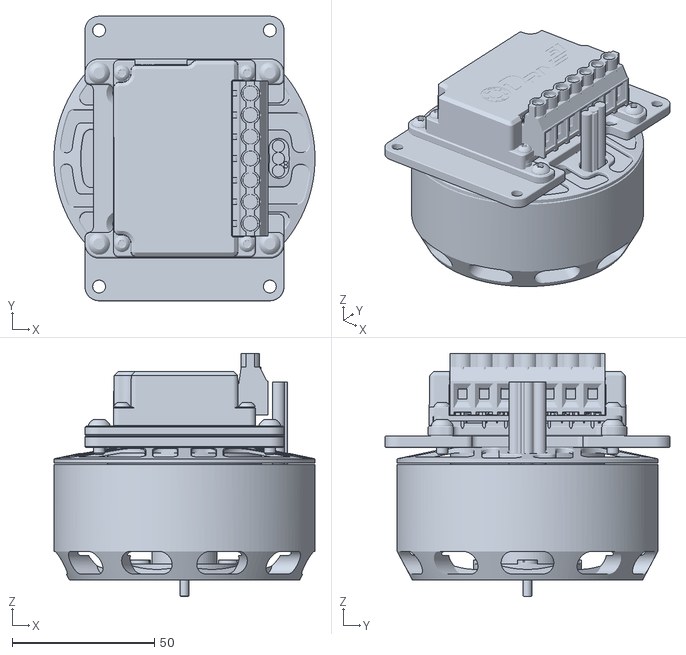
[picture p41: CAD file, 2026-10-18]
hardware/mechanical/steering/Motor.stl
91.7 x 100.0 x 85.4
