autonomous-golf-cart/autonomous-golf-cart/hardware/mechanical/accessories/Monitor Mount.stl

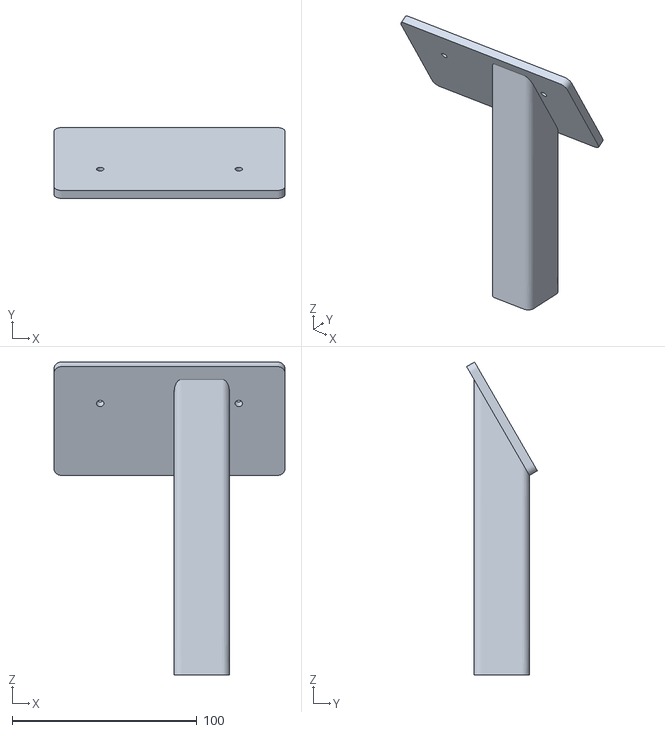
[picture p42: CAD file, 2026-10-18]
hardware/mechanical/accessories/Monitor Mount.stl
125.0 x 38.3 x 169.4
