autonomous-golf-cart/autonomous-golf-cart/hardware/mechanical/cameras/Front Connector.stl

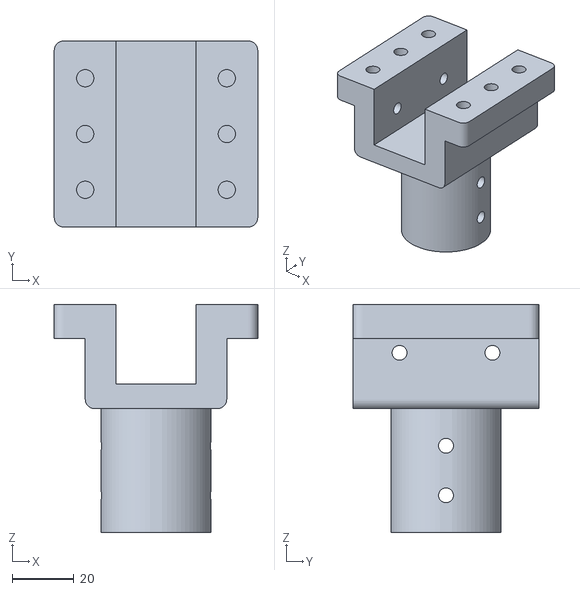
[picture p43: CAD file, 2026-10-18]
hardware/mechanical/cameras/Front Connector.stl
65.7 x 60.0 x 73.6
