autonomous-golf-cart/autonomous-golf-cart/hardware/mechanical/pedals/Gripper Cover.stl

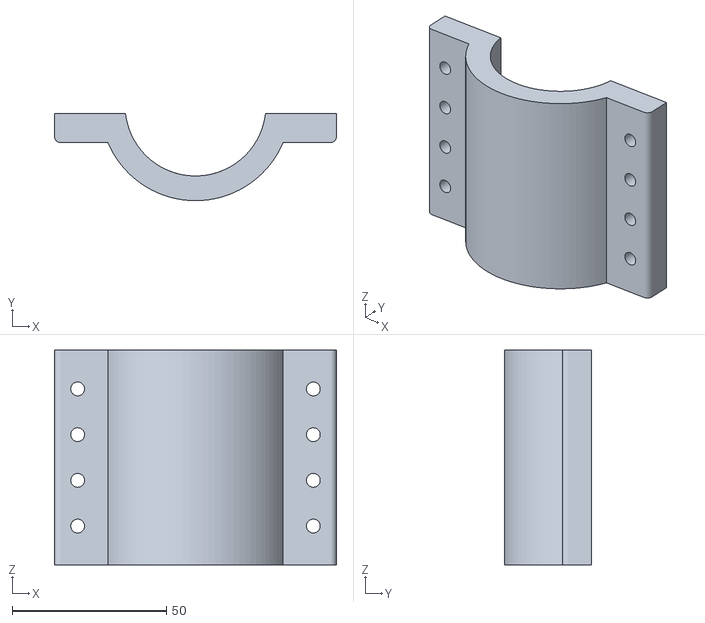
[picture p44: CAD file, 2026-10-18]
hardware/mechanical/pedals/Gripper Cover.stl
91.3 x 28.3 x 69.5
