autonomous-golf-cart/autonomous-golf-cart/hardware/mechanical/sensors/IMU Holster.stl

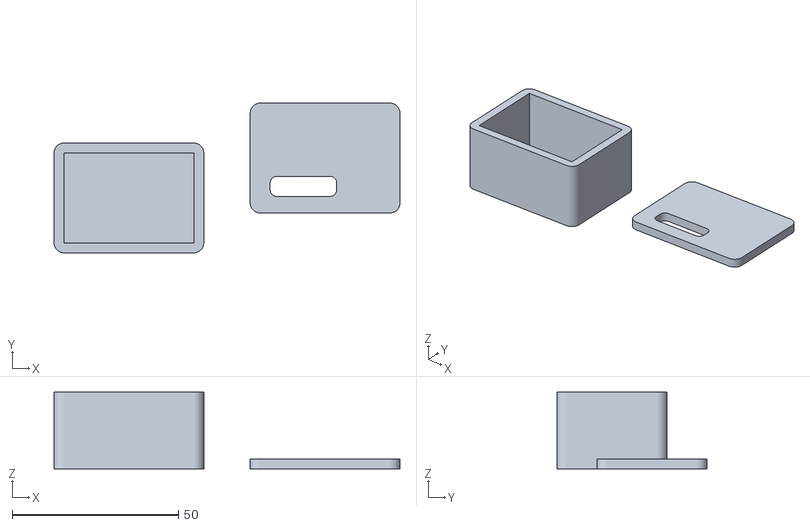
[picture p45: CAD file, 2026-10-18]
hardware/mechanical/sensors/IMU Holster.stl
103.9 x 45.0 x 23.0
