autonomous-golf-cart/autonomous-golf-cart/hardware/mechanical/steering/Chestplate Cover.stl

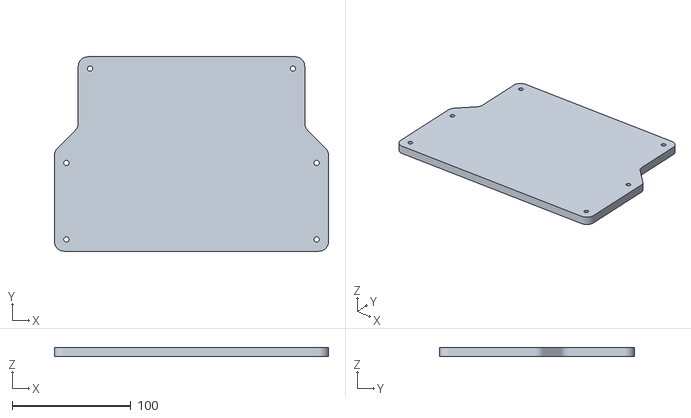
[picture p46: CAD file, 2026-10-18]
hardware/mechanical/steering/Chestplate Cover.stl
231.0 x 164.0 x 8.00
