autonomous-golf-cart/autonomous-golf-cart/hardware/mechanical/accessories/Starlink Mount.stl

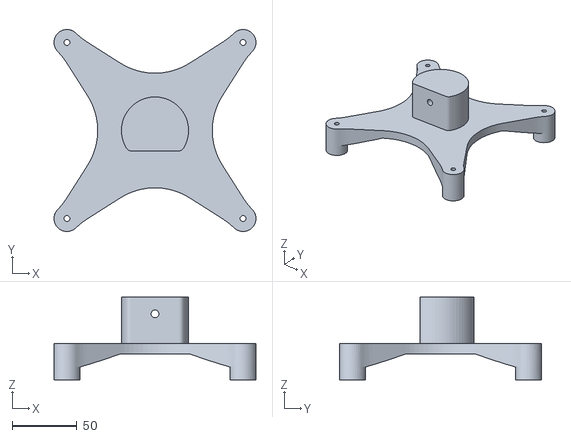
[picture p47: CAD file, 2026-10-18]
hardware/mechanical/accessories/Starlink Mount.stl
155.9 x 155.8 x 64.0
