autonomous-golf-cart/autonomous-golf-cart/hardware/mechanical/cameras/Front Wide Cam Holder.stl

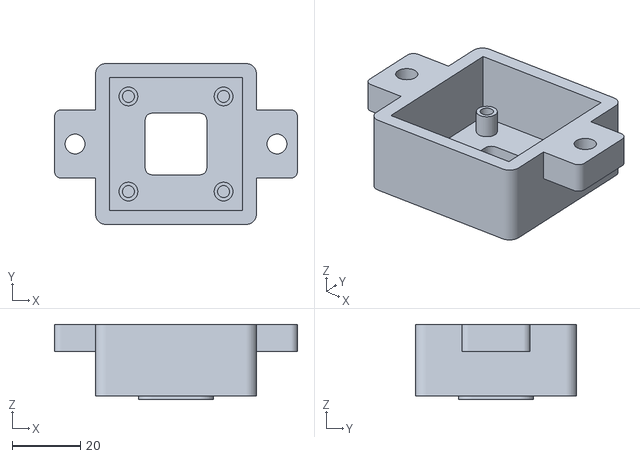
[picture p48: CAD file, 2026-10-18]
hardware/mechanical/cameras/Front Wide Cam Holder.stl
71.0 x 47.0 x 22.0
