autonomous-golf-cart/autonomous-golf-cart/hardware/mechanical/pedals/Piston Arm.stl

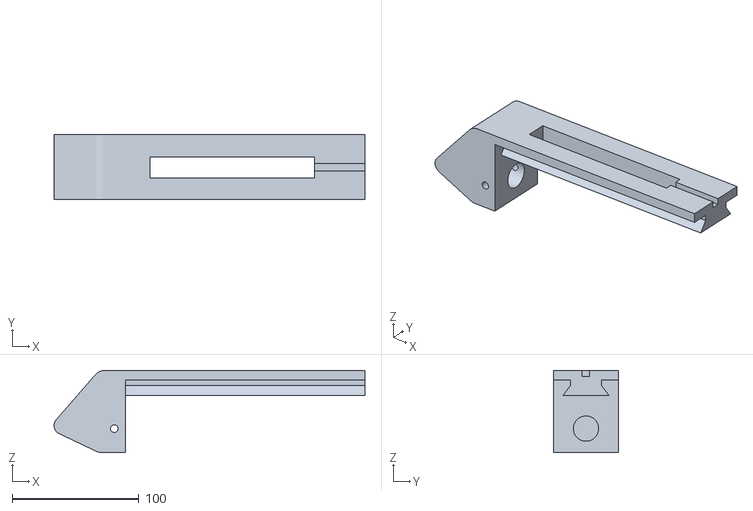
[picture p49: CAD file, 2026-10-18]
hardware/mechanical/pedals/Piston Arm.stl
245.6 x 51.5 x 65.0
