autonomous-golf-cart/autonomous-golf-cart/hardware/mechanical/steering/Idler Tensioner Cover.stl

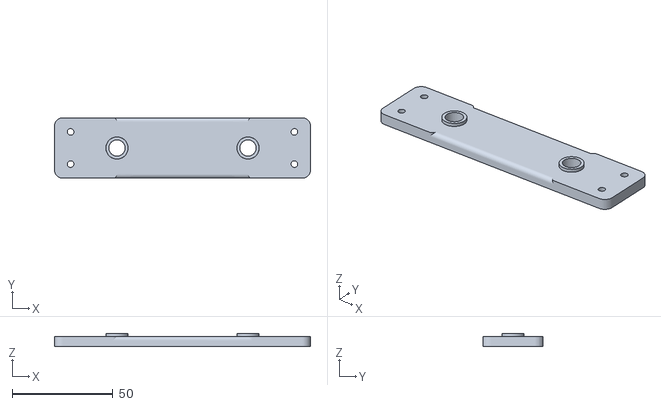
[picture p50: CAD file, 2026-10-18]
hardware/mechanical/steering/Idler Tensioner Cover.stl
127.0 x 30.0 x 6.50
