autonomous-golf-cart/autonomous-golf-cart/hardware/mechanical/pedals/Pedal Cover (BRAKE) U.stl

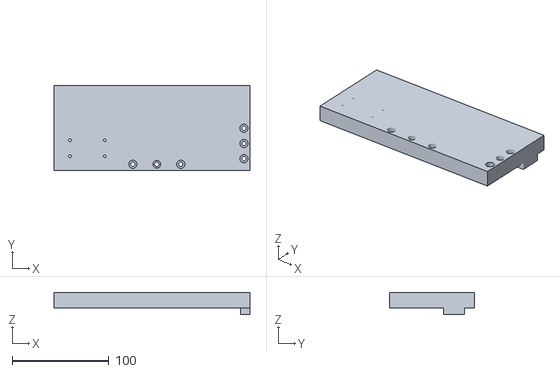
[picture p51: CAD file, 2026-10-18]
hardware/mechanical/pedals/Pedal Cover (BRAKE) U.stl
202.5 x 87.5 x 23.0
