autonomous-golf-cart/autonomous-golf-cart/hardware/mechanical/steering/Motor Belt Pulley.stl

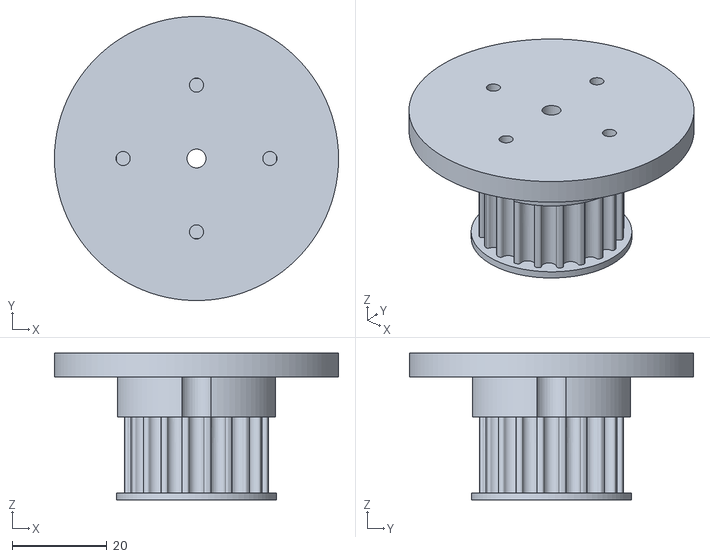
[picture p52: CAD file, 2026-10-18]
hardware/mechanical/steering/Motor Belt Pulley.stl
60.0 x 60.0 x 31.0
