autonomous-golf-cart/autonomous-golf-cart/hardware/mechanical/cameras/Front Connector Cap.stl

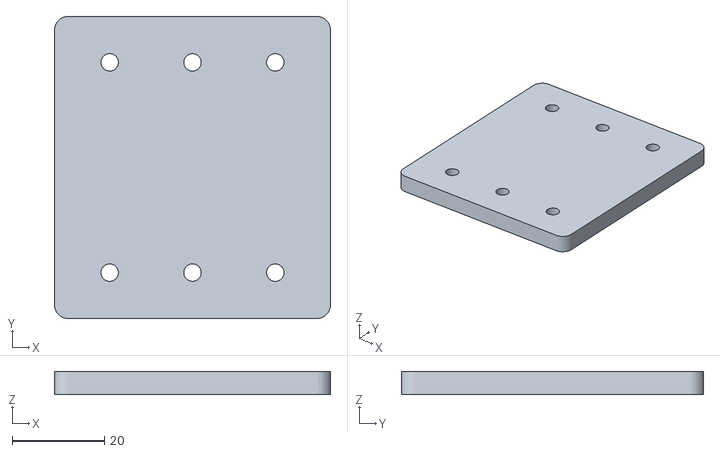
[picture p53: CAD file, 2026-10-18]
hardware/mechanical/cameras/Front Connector Cap.stl
60.0 x 65.7 x 5.00
