autonomous-golf-cart/autonomous-golf-cart/hardware/mechanical/pedals/Column Stand.stl

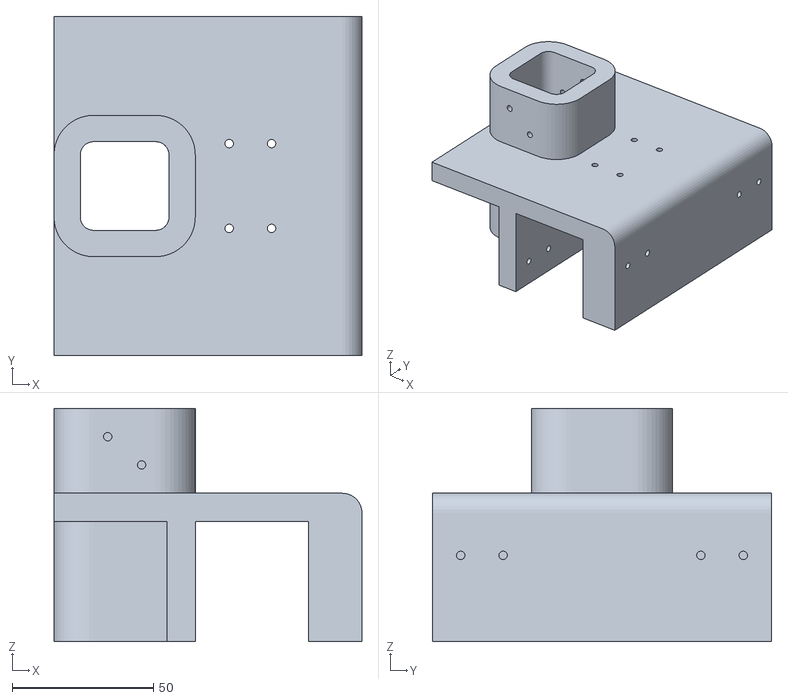
[picture p54: CAD file, 2026-10-18]
hardware/mechanical/pedals/Column Stand.stl
109.0 x 120.0 x 82.5
