autonomous-golf-cart/autonomous-golf-cart/hardware/mechanical/steering/Idler Tensioner Body.stl

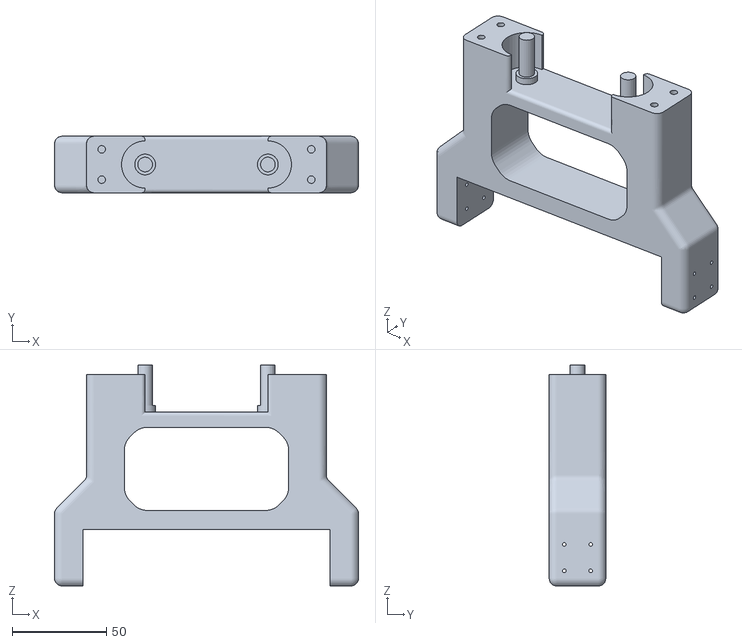
[picture p55: CAD file, 2026-10-18]
hardware/mechanical/steering/Idler Tensioner Body.stl
161.0 x 30.0 x 117.0
