autonomous-golf-cart/autonomous-golf-cart/hardware/mechanical/cameras/Front Cam Attachment.stl

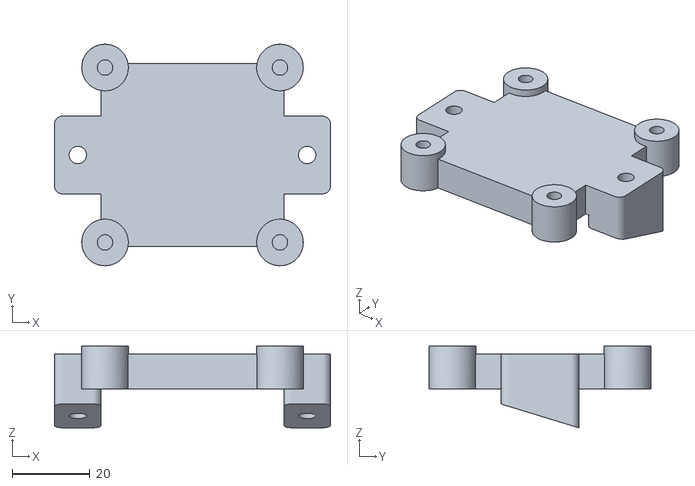
[picture p56: CAD file, 2026-10-18]
hardware/mechanical/cameras/Front Cam Attachment.stl
71.0 x 57.0 x 21.0
