autonomous-golf-cart/autonomous-golf-cart/hardware/mechanical/pedals/Pedal Case (GAS) U.stl

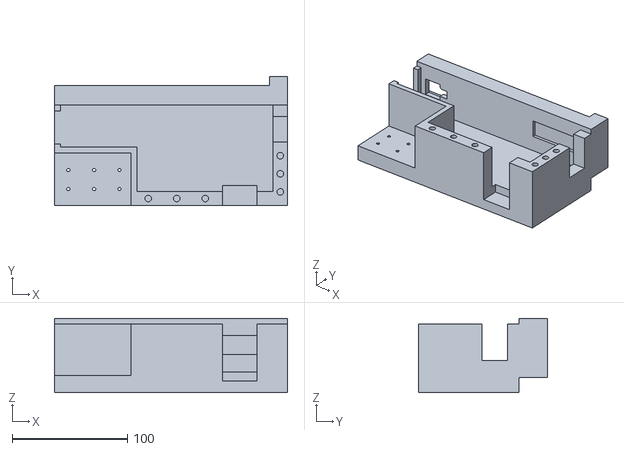
[picture p57: CAD file, 2026-10-18]
hardware/mechanical/pedals/Pedal Case (GAS) U.stl
202.5 x 112.5 x 64.5
