autonomous-golf-cart/autonomous-golf-cart/hardware/mechanical/steering/Steering Column Mount.stl

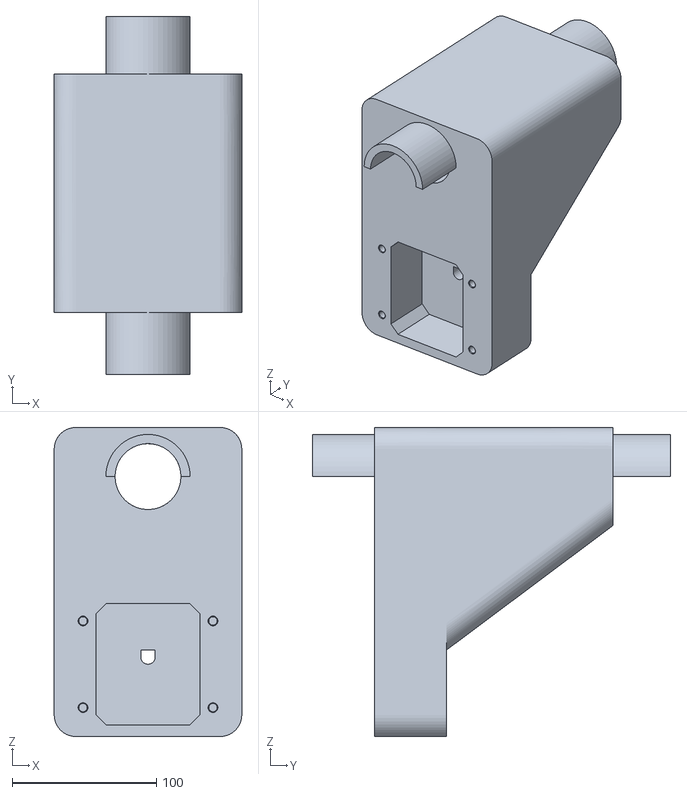
[picture p58: CAD file, 2026-10-18]
hardware/mechanical/steering/Steering Column Mount.stl
130.0 x 248.0 x 214.0
