autonomous-golf-cart/autonomous-golf-cart/hardware/mechanical/cameras/Front Cam Cap.stl

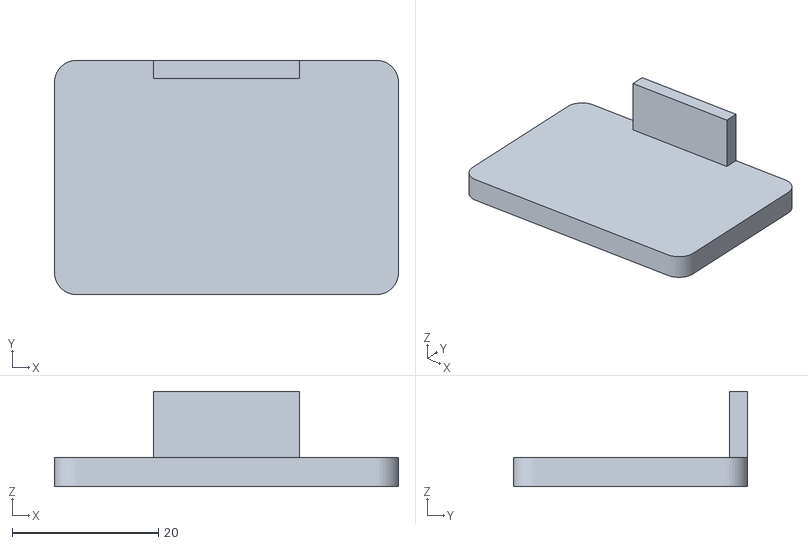
[picture p59: CAD file, 2026-10-18]
hardware/mechanical/cameras/Front Cam Cap.stl
47.0 x 32.0 x 13.0
