autonomous-golf-cart/autonomous-golf-cart/hardware/mechanical/pedals/Pedal Cover (GAS) U.stl

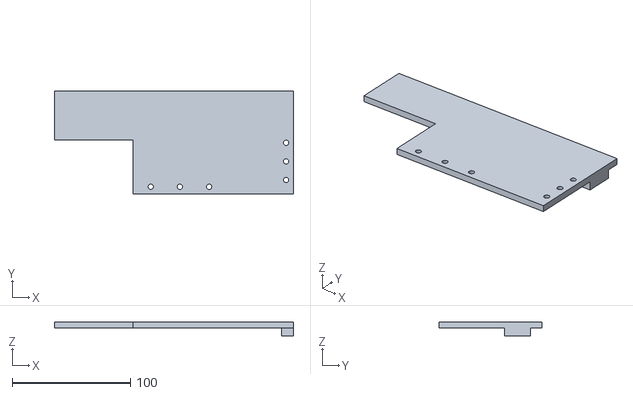
[picture p60: CAD file, 2026-10-18]
hardware/mechanical/pedals/Pedal Cover (GAS) U.stl
202.5 x 87.5 x 12.0
