autonomous-golf-cart/autonomous-golf-cart/hardware/mechanical/steering/Chestplate Mount.stl

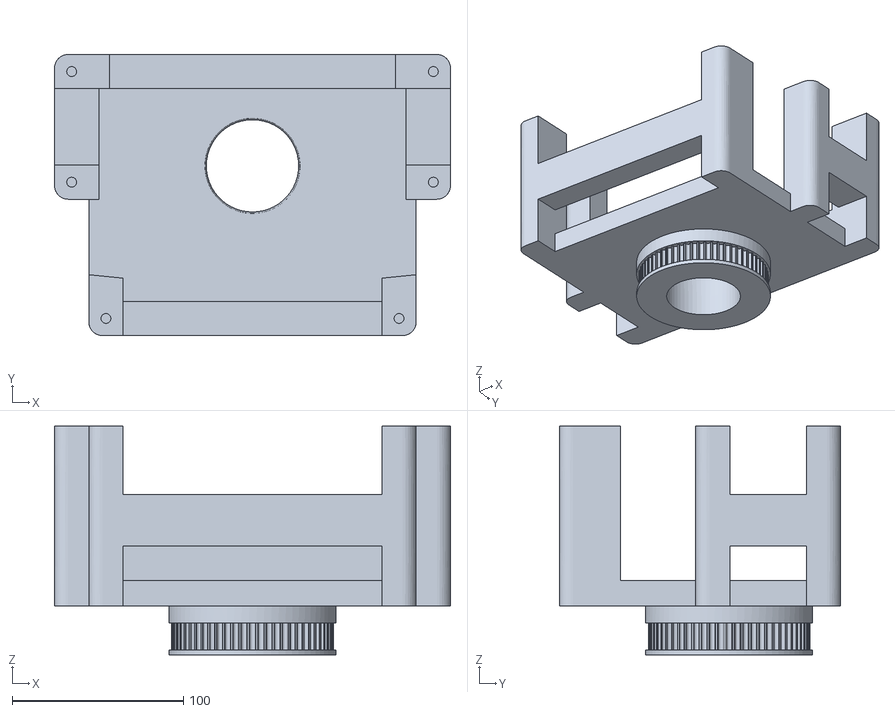
[picture p61: CAD file, 2026-10-18]
hardware/mechanical/steering/Chestplate Mount.stl
231.0 x 164.0 x 133.5
