autonomous-golf-cart/autonomous-golf-cart/hardware/mechanical/cameras/PVC Cam Holder Norm.stl

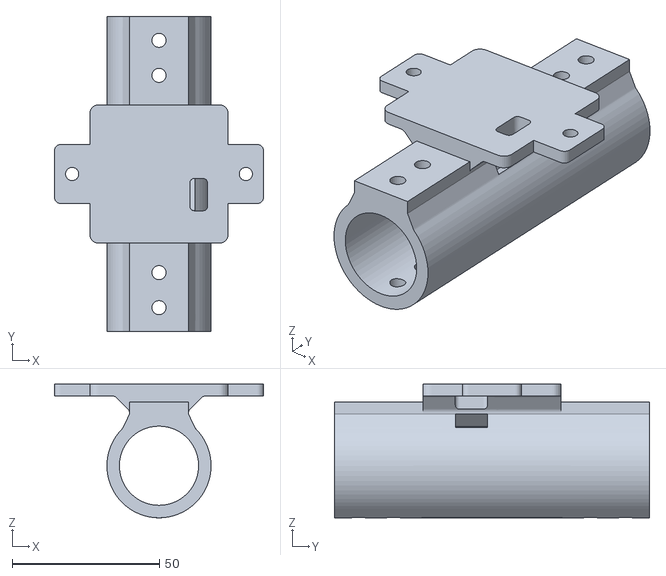
[picture p62: CAD file, 2026-10-18]
hardware/mechanical/cameras/PVC Cam Holder Norm.stl
71.0 x 107.0 x 45.4
