autonomous-golf-cart/autonomous-golf-cart/hardware/mechanical/pedals/Gripper.stl

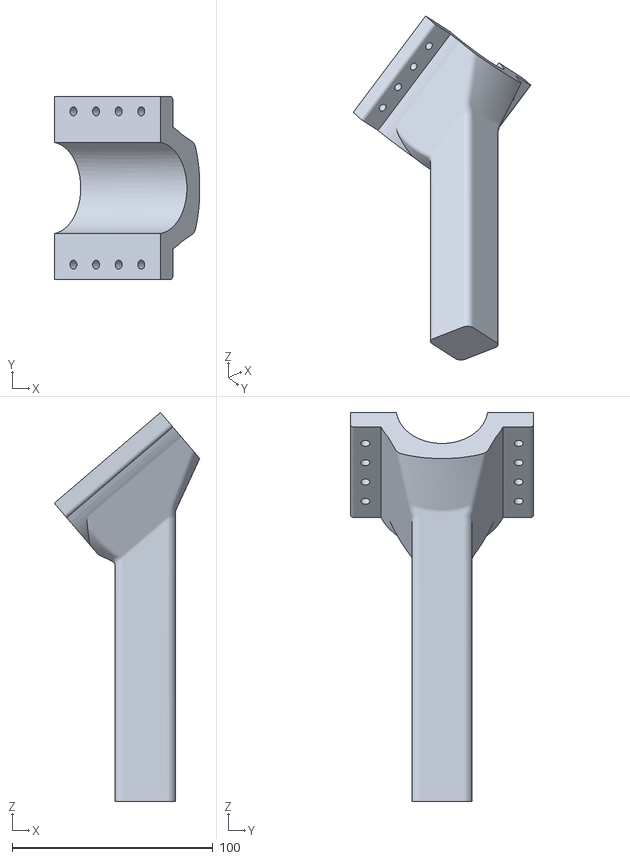
[picture p63: CAD file, 2026-10-18]
hardware/mechanical/pedals/Gripper.stl
72.4 x 91.3 x 193.6
