autonomous-golf-cart/autonomous-golf-cart/hardware/mechanical/cameras/PVC Cam Holder Left.stl

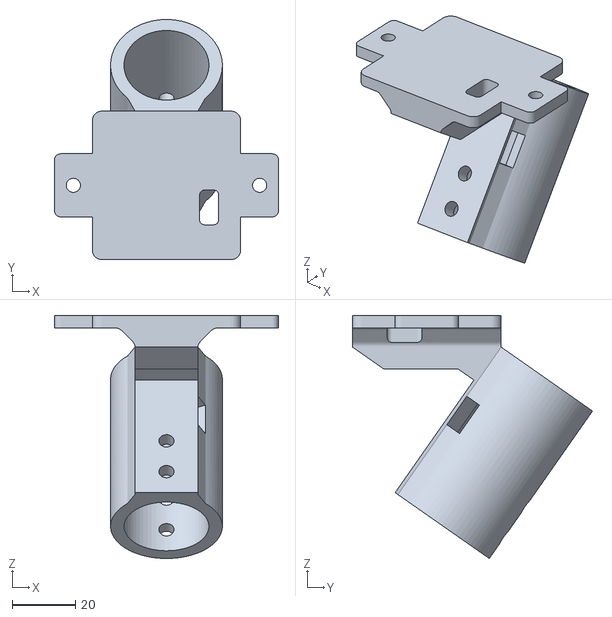
[picture p64: CAD file, 2026-10-18]
hardware/mechanical/cameras/PVC Cam Holder Left.stl
71.0 x 76.0 x 77.0
