autonomous-golf-cart/autonomous-golf-cart/hardware/mechanical/cameras/Front Cam Holder.stl

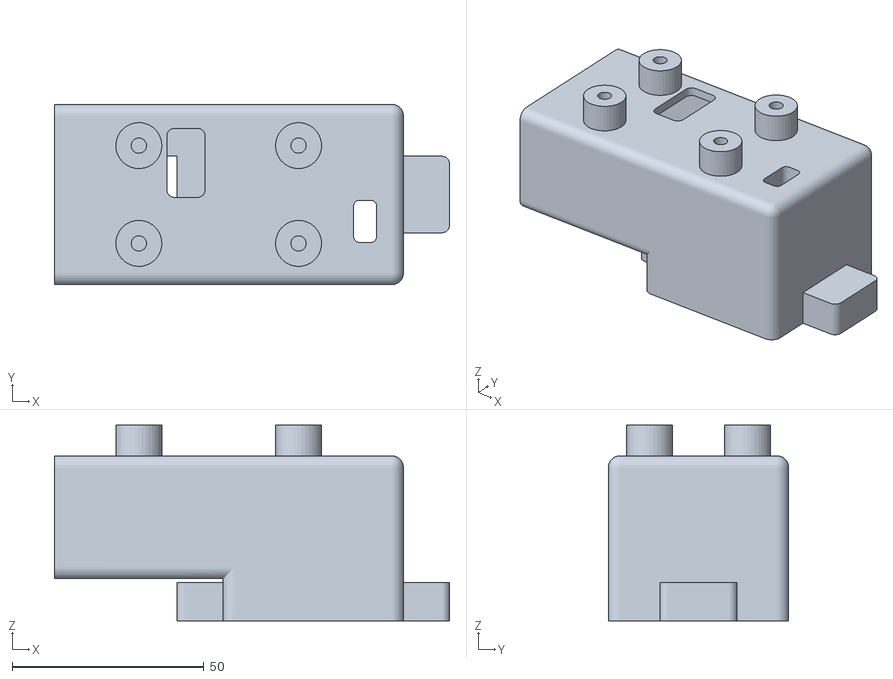
[picture p65: CAD file, 2026-10-18]
hardware/mechanical/cameras/Front Cam Holder.stl
103.0 x 47.0 x 51.0
