autonomous-golf-cart/autonomous-golf-cart/hardware/mechanical/cameras/Back Connector.stl

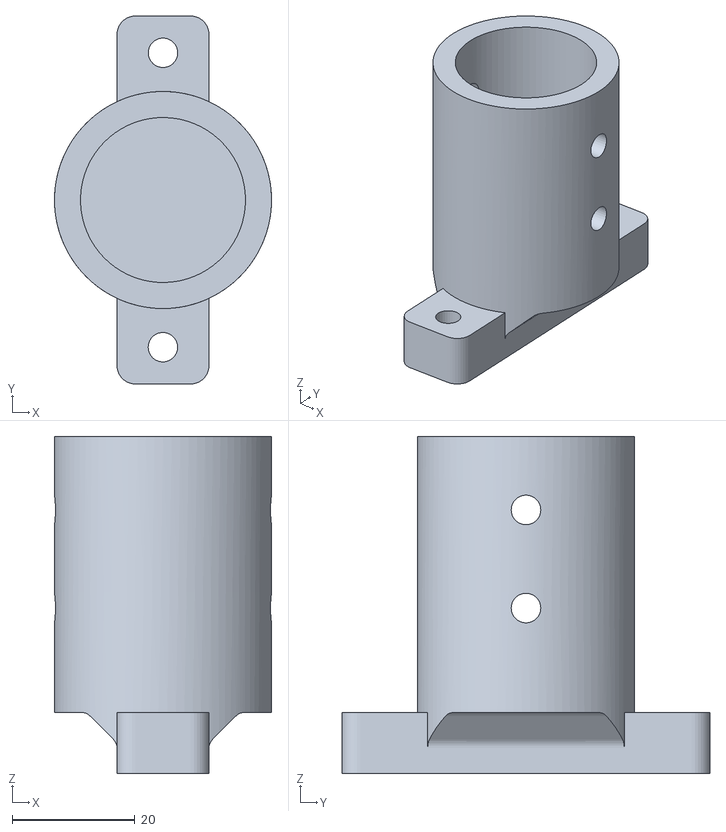
[picture p66: CAD file, 2026-10-18]
hardware/mechanical/cameras/Back Connector.stl
35.4 x 60.0 x 55.0
