autonomous-golf-cart/autonomous-golf-cart/(list of files, cad)

Other CAD files:
hardware/mechanical/cameras/Side Cam Holder.stl
hardware/mechanical/cameras/PVC Cam Holder Right.stl
hardware/mechanical/cameras/Front Cam Holder (OLD).stl
