autonomous-golf-cart/autonomous-golf-cart/policies/segmentation/calibration/calibration_frame.jpg

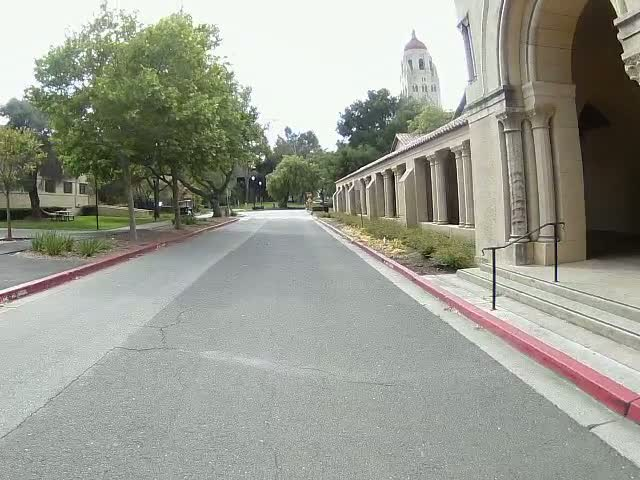
policies/segmentation/calibration/calibration_frame.jpg
