autonomous-golf-cart/autonomous-golf-cart/(commit log)

2026-10-14 Reorganize policies/segmentation into segdrive library + tools/cloud/onboard
    - segdrive/: shared library split out of render.py, path_planning.py,
    render_trajectories.py and live.py (bev, planning, steering, draw,
    segformer, cityscapes, video, paths)
    - calibration/: camera_calibration.json, bev_tuner.html, reference frame
    - tools/: local CPU render/debug scripts; cloud/: Modal jobs (dropped _modal suffix)
    - Central paths module replaces hardcoded data/output dirs; SEGDRIVE_DATA_DIR override
    - Fix debug_bev (was importing a nonexistent function)
    - README documents the new layout
2026-10-14 live.py: default to camera 0 when no recorded drive; simplify README quick start
2026-10-14 segmentation: add onboard/drive.py to drive the cart from the planner sidecar
    Replaces ps5_drive.py --autosteer (PRODUCTION repo) with a cartlib-based
    loop: same freshness check (0.30 s + inference flag), same steering sign
    and ±270° clamp, gas/brake pass-through with caps. Without a PS5 operator,
    a stale planner releases gas and brakes after 1 s. Dry run unless
    --i-understand-this-drives.
2026-10-14 docs/architecture: describe the current repo layout
    Replace the old scripts/ tree and the 'staged but not yet executed'
    refactor plan with the actual cart-api / policies / hardware layout,
    fix upload.py commands, and flag that cartlib/config.py, limits.py and
    cart_limits.h currently disagree on several limits.
2026-10-18 feat(pedals): add brake pedal case and cover
    Brake pedal assembly: case for the actuator mechanism.
    Brake pedal assembly: cover matching the brake case.
    Includes both original STL exports and their shaded CAD previews.
2026-10-18 feat(pedals): add gas pedal case and cover
    Accelerator pedal assembly: case for the actuator mechanism.
    Accelerator pedal assembly: cover matching the gas case.
    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
2026-10-18 feat(pedals): add piston arm
    Pedal actuation linkage; also visible as a component in the supplied brake-assembly reference.
    Includes the original STL export and its shaded CAD preview.
2026-10-18 feat(pedals): add column stand
    Pedal-frame retention: the stand to which the gripper attaches, linking the wooden actuator-support structure to the clamp on the steering column.
    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
2026-10-18 feat(pedals): add pedal-frame gripper and cover
    Pedal-frame retention: connected to the column stand and clamped around the steering column to keep the wooden actuator frame from lifting as the actuators press the gas or brake.
    Pedal-frame retention: mating cover for the gripper clamp around the steering column, securing the wooden pedal-actuator frame against lift.
    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
2026-10-18 feat(steering): add steering column mount
    Steering assembly: mounting bracket at the steering column.
    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
2026-10-18 feat(steering): add steering motor and controller model
    Steering assembly: supplied motor and controller geometry for packaging and fit reference; not identified as a printable custom part.
    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
2026-10-18 feat(steering): add motor belt pulley
    Steering belt drive: pulley on the motor side.
    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
2026-10-18 feat(steering): add idler tensioner body and cover
    Steering belt drive: body of the idler/tensioner assembly.
    Steering belt drive: cover for the idler/tensioner assembly.
    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
2026-10-18 feat(steering): add steering-wheel chestplate and cover
    Steering-wheel interface: chestplate fitted over the steering wheel to transmit the steering drive and turn the wheel.
    Steering-wheel interface: cover for the chestplate assembly fitted over the steering wheel.
    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
2026-10-18 feat(cameras): add camera-to-cart mount and front attachment
    Camera rig: mounting interface between a camera bracket and the cart.
    Front camera rig: attachment plate/interface.
    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
2026-10-18 feat(cameras): add front camera holder and cap
    Front camera rig: camera holder.
    Front camera rig: cap for the front camera holder.
    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
2026-10-18 feat(cameras): add front wide-camera holder
    Front wide-angle camera: camera holder.
    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
2026-10-18 feat(cameras): add side camera holder
    Side-facing camera rig: camera holder.
    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
2026-10-18 feat(cameras): add pvc camera holder, normal
    PVC camera rig: normal variant of the tube-mounted bracket.
    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
2026-10-18 feat(cameras): add pvc camera holder, left
    PVC camera rig: left variant of the tube-mounted bracket.
    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
2026-10-18 feat(cameras): add pvc camera holder, right
    PVC camera rig: right variant of the tube-mounted bracket.
    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
2026-10-18 feat(cameras): add front camera holder, old revision
    Earlier front camera holder export; retained separately from the unmarked revision.
    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
2026-10-18 feat(cameras): add front connector and cap
    Front camera mounting: holds the front camera in place with a vibration damper.
    Front camera mounting: cap for the vibration-damped front connector assembly.
    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
2026-10-18 feat(cameras): add back connector
    Rear camera mounting: holds the rear camera in place with a vibration damper.
    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
2026-10-18 feat(sensors): add gps housing
    GPS sensor mounting: housing export includes the enclosure and a separate lid.
    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
2026-10-18 feat(sensors): add imu holster
    IMU sensor mounting: holster export includes the enclosure and a separate lid.
    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
2026-10-18 feat(accessories): add monitor mount and stand
    Operator display: mounting bracket for the monitor.
    Operator display: support stand for the monitor.
    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
2026-10-18 feat(accessories): add starlink mount
    Connectivity hardware: mount for the Starlink equipment.
    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
2026-10-18 docs(hardware): document 33 mechanical components and embed catalog
    Describe each component and its cart installation, including the steering-wheel chestplate, pedal-frame retention clamp, and vibration-damped camera connectors.
2026-10-18 docs(hardware): add installed-hardware photo and refresh catalog
    Add the annotated cart and steering assembly photo to both READMEs, explain the mechanical hardware, and describe the pictured six-camera configuration. Use Geist Regular and Geist Mono Regular in the catalog, remove the component count badge, and show the full catalog in the hardware README.
2026-10-22 fix(limits): widen steering soft limits to the measured ±320°
2026-10-22 fix(limits): match actuator PWM to the 230 duty the firmware uses
2026-10-22 fix(firmware): sync cart_limits.h steering limits with limits.py
2026-10-22 docs(steering): update soft-limit table to ±320°
2026-10-22 test(cartlib): cover steering degree/motor-turn conversions
2026-10-22 test(cartlib): cover geo distance, bearing, projection, and path snapping
2026-10-22 chore(hardware): remove empty electrical/ and pcb/ placeholders
2026-10-22 chore(hardware): drop cad/.gitkeep now that catalog.json lives there
2026-10-22 docs(pedals): watchdog brakes rather than releasing both pedals
2026-10-22 docs(ps5): watchdog applies the brake on a yanked cable
2026-10-22 docs(firmware): header comment matches brake-on-failsafe behavior
