autonomous-golf-cart/autonomous-golf-cart/(notices)

Notices in the files:
README.md:
License: MIT
